mrsilvosa/portfolio/Light-Spectrometre/nucleo-f446re-project/interface.png

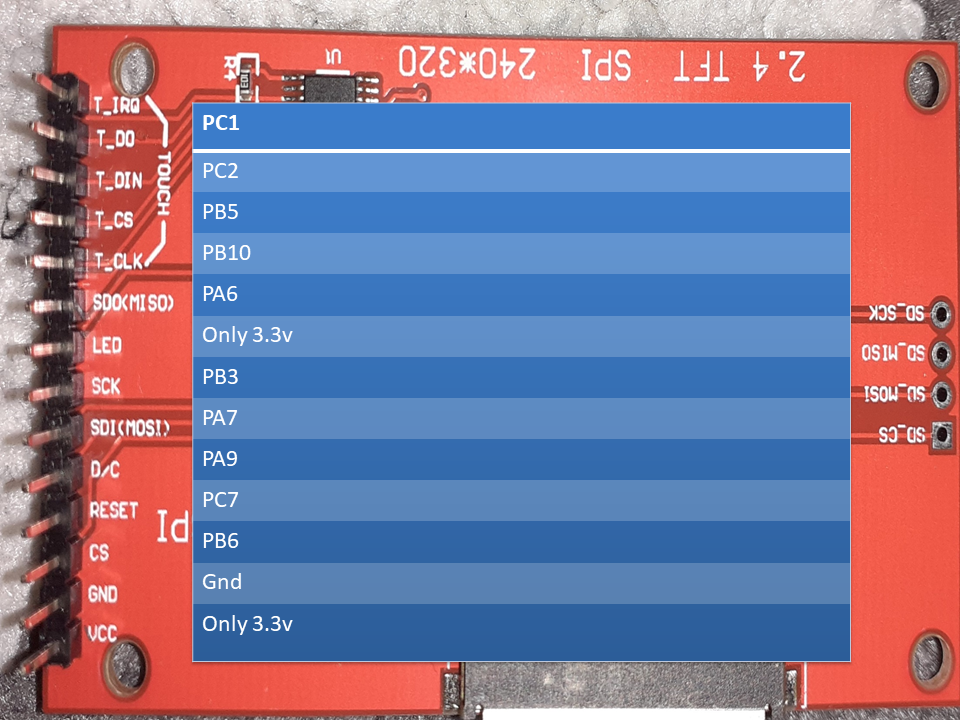
Light-Spectrometre/nucleo-f446re-project/interface.png
