mrsilvosa/portfolio/README.md

# MRS Portfolio
Project's general folder.
You can check for each project within it which will be in separate folders.
