mrsilvosa/portfolio/Light-Spectrometre/README.md

This folder contains every part of the Light Spectrometre project, including PCB layout, manuals detailing most important aspects of the project, microcontroller and PC projects.
