mrsilvosa/portfolio/Light-Spectrometre/Anteproyecto.docx

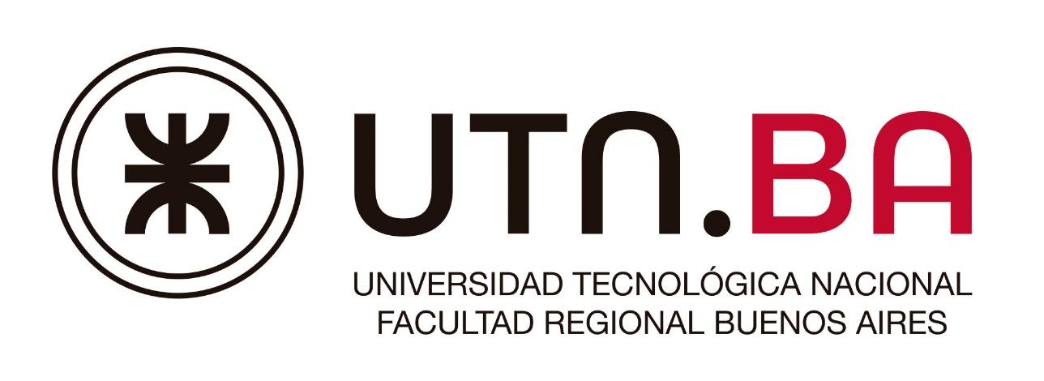
[picture p2: figure]
Qué significa el logo de la UTN.BA? - UTN.BA

Anteproyecto de proyecto integrador de materia

Técnicas Digitales II

Universidad Tecnológica Nacional – Facultad Regional Buenos Aires
Materia: | Técnicas Digitales II
Curso: | R4001
Cuerpo docente: | Ing. Juan Manuel Cruz Ing. Juan Carlos Paradiso Ing. Juan Ignacio Bacigalupo
Título del Proyecto: | Espectrómetro de Luz
Número de grupo: | Grupo -
Integrantes del grupo: | Franco Gabriel Mendez
| Martin Rodriguez Silvosa
Año de cursada: | 2025

# 1. Introducción

Este proyecto tiene como objetivo desarrollar un sistema portátil y de bajo costo capaz de medir el espectro de una fuente de luz visible, utilizando una placa Núcleo F446RE junto con un sensor espectral. A partir de los datos recolectados, se podrá visualizar en tiempo real la distribución espectral, permitiendo comparar diferentes tipos de lámparas, analizar sus pigmentos, etc.

# 2. Desarrollo

- El sensor AS7262 es el que usaremos para medir la intensidad de las longitudes de onda.
- Se utilizan una sensor LDR que nos permite medir un adc la intensidad de luz del ambiente y variar el brillo de la pantalla
- Se utiliza FreeRTOS con sus respectivas tareas para el manejo de toda la información y sensado.
- Utilizaremos la comunicación I2C para la comunicación con el sensor y SPI para la pantalla TFT
- Utilizaremos un Display Gráfico – para el muestreo del espectro de luz.
- Tendrá un USB que nos facilitará el envío de nuestro mediciones a una PC
- Usaremos un gabinete impreso en 3D para mejorar la presentación y para facilitar la interacción con el usuario.

# 3. Diagrama en bloques

Sensores

Micro

Display

PC

Fuente de Luz

# 4. Panel de firmas

| | | Firma
Integrante I | | | Integrante II
Fecha: 3/06/2025 | | | Fecha: 3/06/2025
