mrsilvosa/portfolio/Light-Spectrometre/nucleo-f446re-project/interface.pdf

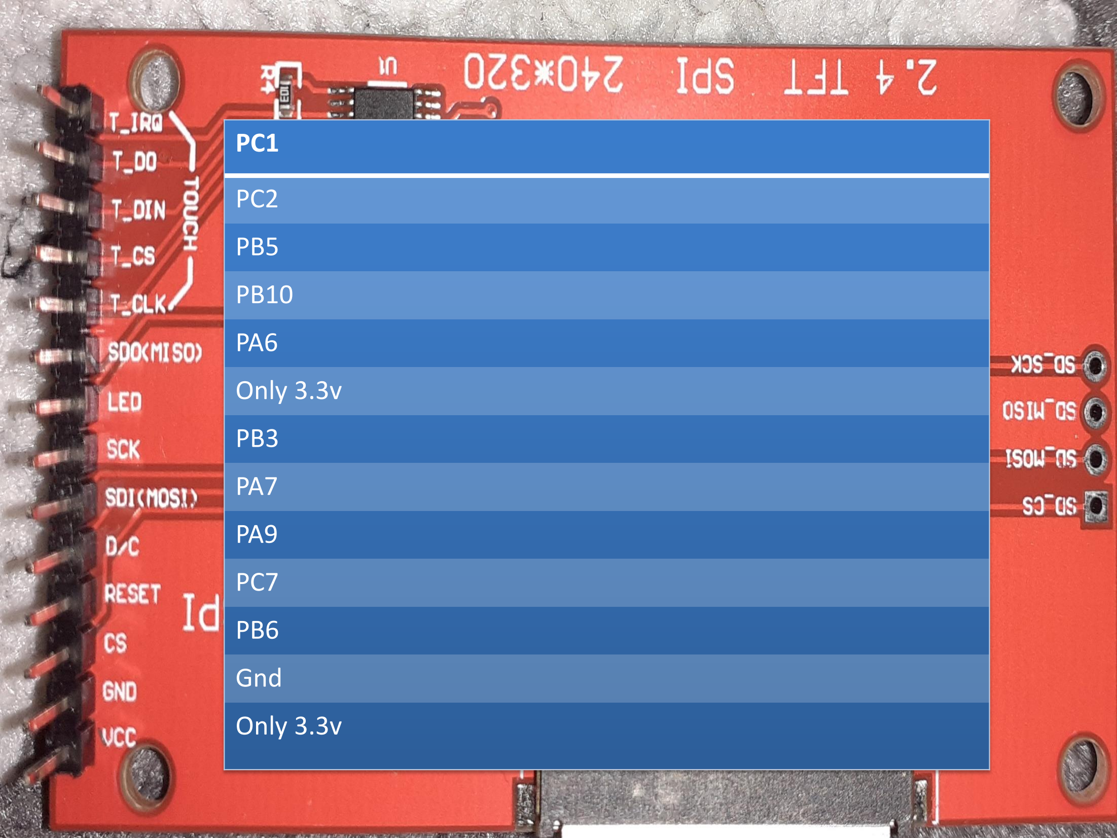
[picture p3: page 1]

PC1

PC2
PB5
PB10
PA6
Only 3.3v
PB3
PA7
PA9
PC7
PB6
Gnd
Only 3.3v
