mrsilvosa/portfolio/Light-Spectrometre/PC-Qt-project/20251220_202518_intensity.ods

index | value
0 | 0,0000480380804
1 | 0,0000623318701
2 | 0,0000805907985
3 | 0,00010382347
4 | 0,000133267808
5 | 0,000170438492
6 | 0,000217174485
7 | 0,000275702099
8 | 0,000348699949
9 | 0,000439376745
10 | 0,000551551755
11 | 0,000689760083
12 | 0,000859338732
13 | 0,0010665491
14 | 0,00131868769
15 | 0,00162421959
16 | 0,00199289736
17 | 0,00243589189
18 | 0,00296595832
19 | 0,00359750492
20 | 0,00434675254
21 | 0,00523182657
22 | 0,00627286127
23 | 0,00749204215
24 | 0,00891361013
25 | 0,0105640134
26 | 0,0124716302
27 | 0,0146668088
28 | 0,0171817038
29 | 0,0200499911
30 | 0,0233065542
31 | 0,026987385
32 | 0,0311287213
33 | 0,0357667431
34 | 0,0409370102
35 | 0,0466736332
36 | 0,0530085415
37 | 0,0599711463
38 | 0,0675866678
39 | 0,0758757815
40 | 0,0848537013
41 | 0,0945290923
42 | 0,104903422
43 | 0,115969732
44 | 0,127713099
45 | 0,140108317
46 | 0,153120711
47 | 0,166705236
48 | 0,180806637
49 | 0,195359349
50 | 0,210287556
51 | 0,22550717
52 | 0,240924224
53 | 0,256437629
54 | 0,271939874
55 | 0,287318051
56 | 0,302457452
57 | 0,317239195
58 | 0,331547469
59 | 0,345267177
60 | 0,358288169
61 | 0,370506585
62 | 0,381826758
63 | 0,39216435
64 | 0,401445061
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
