mrsilvosa/portfolio/Light-Spectrometre/PC-Qt-project/20251221_184616_intensity.ods

index | value
0 | 0,0000802172726
1 | 0,000104334904
2 | 0,000135191978
3 | 0,000174511573
4 | 0,000224409843
5 | 0,000287477509
6 | 0,000366861554
7 | 0,000466373371
8 | 0,000590600539
9 | 0,000745040306
10 | 0,000936237746
11 | 0,0011719662
12 | 0,00146137539
13 | 0,00181520043
14 | 0,00224595354
15 | 0,00276814937
16 | 0,00339851016
17 | 0,00415618997
18 | 0,00506305415
19 | 0,00614379905
20 | 0,00742621813
21 | 0,00894136168
22 | 0,0107237054
23 | 0,0128112147
24 | 0,0152453529
25 | 0,0180713255
26 | 0,021337593
27 | 0,025095934
28 | 0,0294011328
29 | 0,0343104973
30 | 0,0398832634
31 | 0,0461804569
32 | 0,0532633215
33 | 0,0611928403
34 | 0,0700286552
35 | 0,0798277333
36 | 0,0906429216
37 | 0,102522492
38 | 0,115507089
39 | 0,12962921
40 | 0,144911498
41 | 0,161364868
42 | 0,178987399
43 | 0,197762147
44 | 0,217657894
45 | 0,238625228
46 | 0,260597676
47 | 0,283490568
48 | 0,307200909
49 | 0,331607401
50 | 0,356570452
51 | 0,381935567
52 | 0,407530874
53 | 0,43317163
54 | 0,458661377
55 | 0,483794212
56 | 0,508360505
57 | 0,532143235
58 | 0,554930449
59 | 0,576511145
60 | 0,596682787
61 | 0,615253866
62 | 0,632046998
63 | 0,646904349
64 | 0,659686208
65 | 0,670278966
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
