mrsilvosa/portfolio/Light-Spectrometre/PC-Qt-project/20251221_185330_intensity.ods

index | value
0 | 0,000013506261
1 | 0,0000175229688
2 | 0,000022653554
3 | 0,0000291813012
4 | 0,0000374538758
5 | 0,0000478966904
6 | 0,0000610262032
7 | 0,0000774676446
8 | 0,0000979732795
9 | 0,000123444217
10 | 0,000154953028
11 | 0,000193773332
12 | 0,000241403919
13 | 0,000299603096
14 | 0,00037042005
15 | 0,000456231937
16 | 0,000559777603
17 | 0,000684194209
18 | 0,00083306391
19 | 0,00101043296
20 | 0,00122085691
21 | 0,00146942656
22 | 0,0017617963
23 | 0,00210419716
24 | 0,00250343792
25 | 0,00296694739
26 | 0,00350269605
27 | 0,00411921041
28 | 0,00482552219
29 | 0,00563109387
30 | 0,00654572342
31 | 0,00757952873
32 | 0,00874269195
33 | 0,0100453841
34 | 0,0114975991
35 | 0,0131089361
36 | 0,0148883741
37 | 0,0168441944
38 | 0,0189835019
39 | 0,0213121343
40 | 0,0238343887
41 | 0,0265527423
42 | 0,0294676516
43 | 0,0325772092
44 | 0,0358772874
45 | 0,0393608697
46 | 0,0430182926
47 | 0,0468369909
48 | 0,0508015491
49 | 0,0548936613
50 | 0,0590921566
51 | 0,0633735582
52 | 0,067711629
53 | 0,0720781535
54 | 0,0764431208
55 | 0,0807750151
56 | 0,0850418955
57 | 0,0892105848
58 | 0,0932488739
59 | 0,0971247256
60 | 0,100807548
61 | 0,104268558
62 | 0,107481286
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
