mrsilvosa/portfolio/Light-Spectrometre/Manual de Ingenieria.pdf

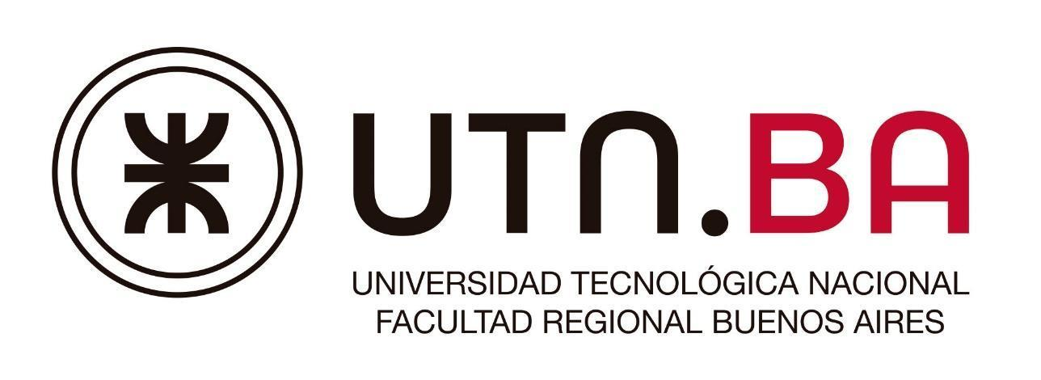
[picture p4: figure]

Manual de Ingeniería Proyecto Integrador Técnicas Digitales II

Universidad Tecnológica Nacional – Facultad Regional Buenos Aires
Materia: | Técnicas Digitales II
Curso: | R4001
Cuerpo docente: | Ing. Juan Manuel Cruz Ing. Juan Carlos Paradiso Ing. Juan Ignacio Bacigalupo
Título del Proyecto: | Espectrómetro de Luz
Número de grupo: | Grupo -
Integrantes del grupo: | Franco Gabriel Méndez
Martín Rodríguez Silvosa
Año de cursada: | 2025

Haga click aquí para volver al índice

# Índice

- Estado del Arte | 3
- Principio de Funcionamiento | 3
- Composición del proyecto | 3
- Esquemáticos y PCB’s | 4
- Código programado, MCU y PC | 10
- Porciones de código relevantes MCU | 11
- Porciones de código relevantes PC | 20
- Consumo Eléctrico: | 23
- Dispositivos y periféricos empleados, detalles | 23
- Tipos de comunicación empleadas | 23
- Cronogramas del proyecto | 24
- Costos del proyecto | 25
- Desafíos | 26
- Conclusiones | 26
- Bibliografía | 27
- Panel de firmas | 27

## - Estado del Arte

El espectrómetro digital está caracterizado por ser una herramienta útil en el análisis de los componentes espectrales de la luz visible, permitiendo medir la intensidad de cada longitud de onda emitida/reflejada por la fuente, calcular indirectamente temperatura de color o iluminancia dependiendo de la aplicación, o evaluar la calidad de la fuente en base a métodos de reproducción de color como los estándares CRI / TM-30.
Convierten estas señales ópticas en datos digitales a partir de métodos de procesamiento de señales a través de algoritmos y software como lo puede ser el análisis de Fourier, para luego en tiempo real obtener información cualitativa y cuantitativa de la luz medida con alta precisión.

## - Principio de Funcionamiento

Nuestro proyecto utiliza principalmente un sensor acondicionado para medir pequeñas bandas de longitud de onda. La luz incide sobre las diferentes subdivisiones de longitud de onda que dispone el dispositivo y se captura una intensidad lumínica sobre cada una mediante un tiempo de integración. Esta información es almacenada en memoria volátil sobre el sensor a la espera de ser leída por el MCU. Una vez capturada y rescatada la información, se procesa mediante un algoritmo estadístico y se refleja el espectro en pantalla con un valor de intensidad por longitud de onda proporcional a la intensidad medida total.

## - Composición del proyecto

Para desarrollar esta tarea, decidimos utilizar los siguientes dispositivos:
- STM32 Núcleo-F446RE como MCU principal
- Pantalla TFT ILI9341 para la visualización de la interfaz gráfica
- Memoria SD integrada dentro del ILI9341 para el almacenamiento del GUI
- Sensor TCS34725 como análisis espectral ante el fallo imprevisto del AS7262
- Sensor LDR de intensidad lumínica para la retroiluminación de la pantalla
- Pulsadores varios para el desplazamiento y selección dentro del GUI
- Baterías AA como fuente de alimentación del dispositivo portátil
- Llave selectora para el encendido y apagado del proyecto
- Conector USB para subir los datos espectrales tomados a PC con aplicación propia
- Gabinete impreso en 3D que almacena todos los dispositivos empleados

## - Esquemáticos y PCB’s

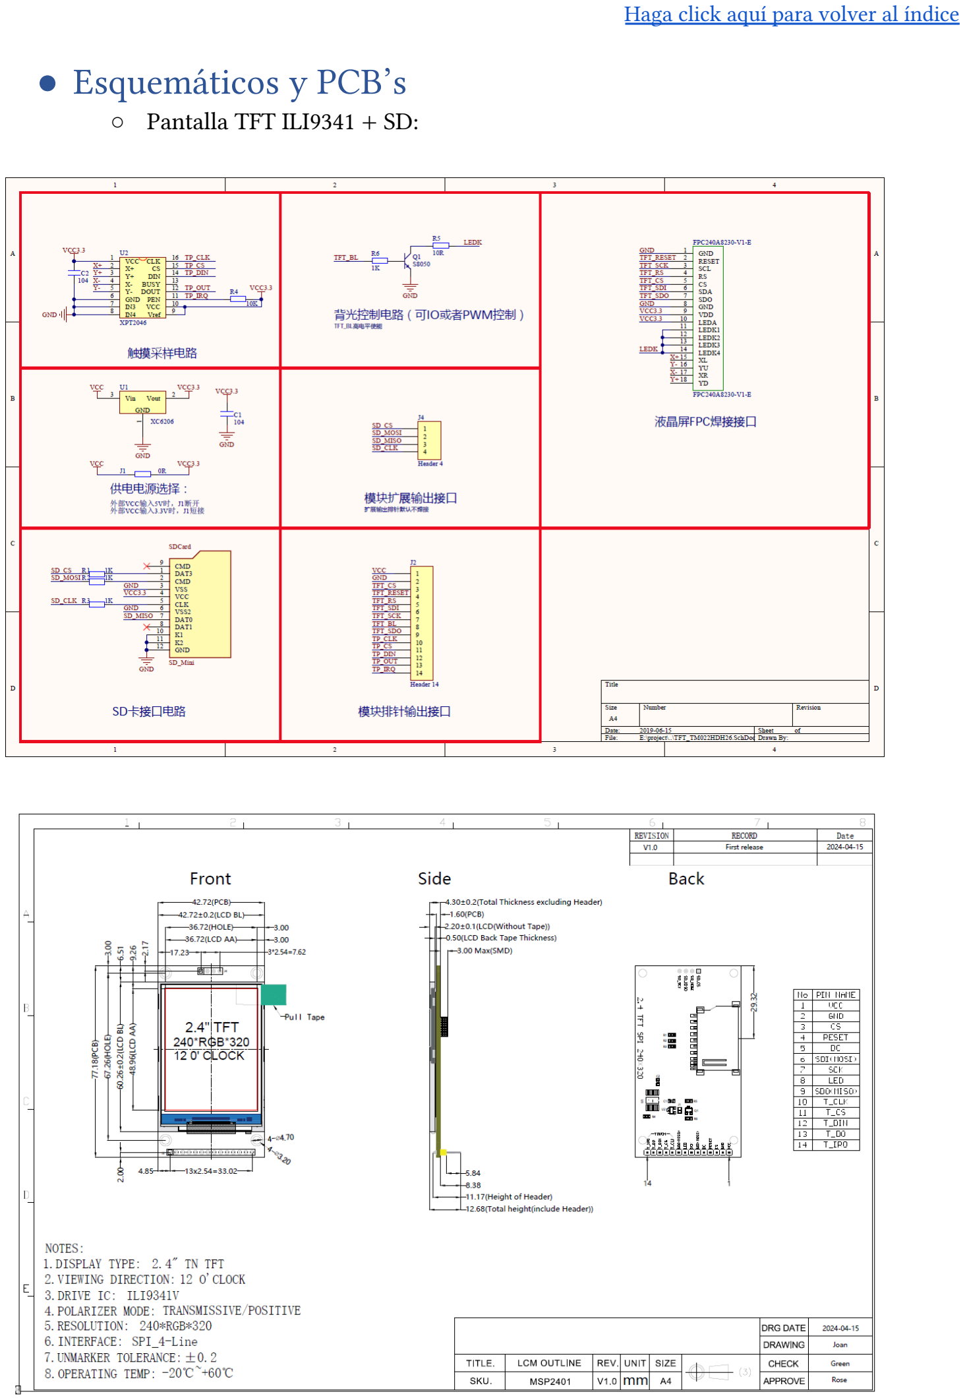
[picture p5: page 4]

- Pantalla TFT ILI9341 + SD:

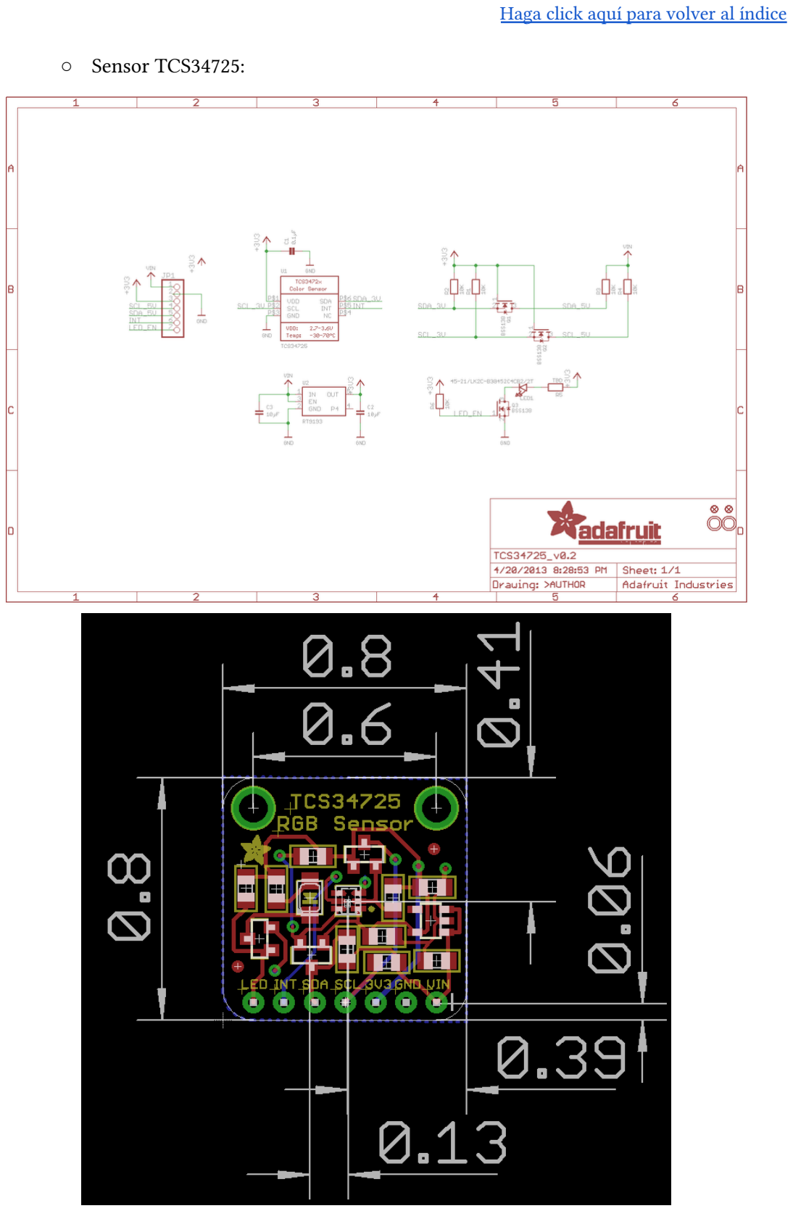
[picture p6: page 5]

Haga click aquí para volver al índice ○ Sensor TCS34725:

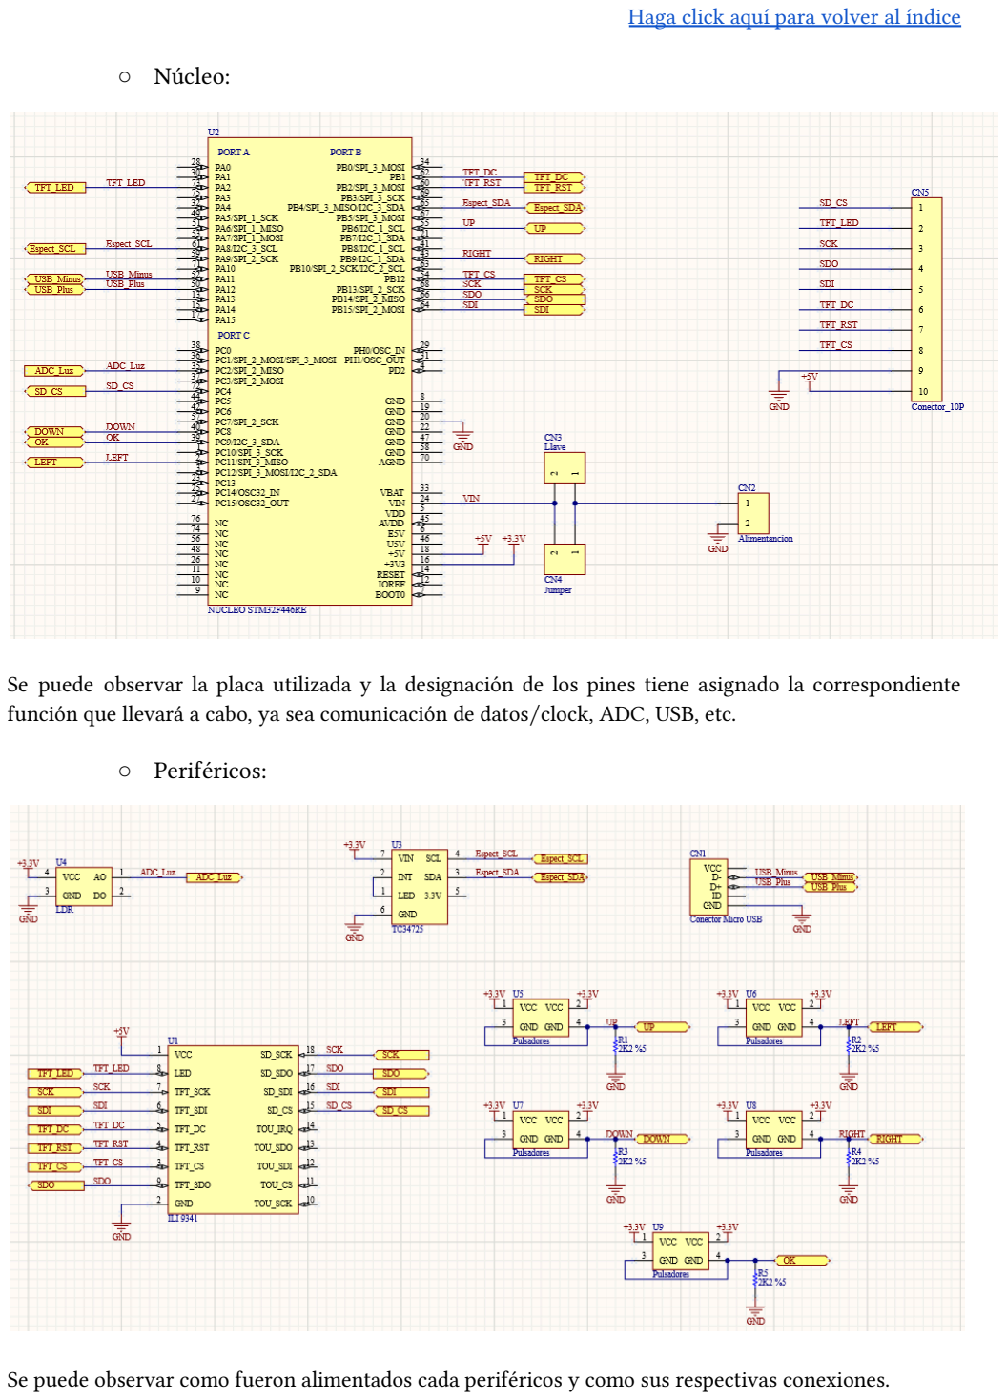
[picture p7: page 6]

- Núcleo:

Se puede observar la placa utilizada y la designación de los pines tiene asignado la correspondiente función que llevará a cabo, ya sea comunicación de datos/clock, ADC, USB, etc.

- Periféricos:

Se puede observar como fueron alimentados cada periféricos y como sus respectivas conexiones.

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
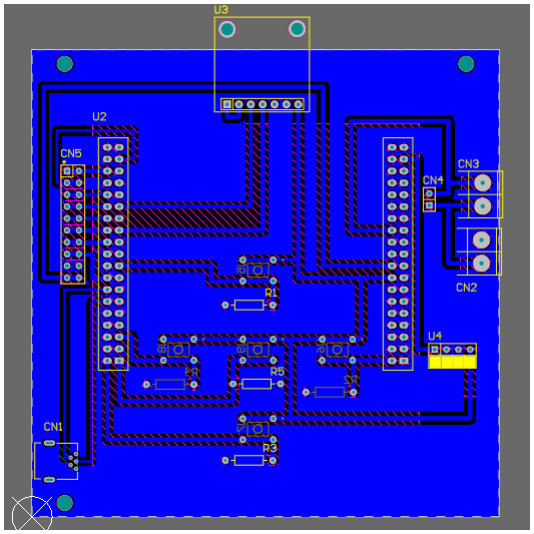
[picture p8: figure]
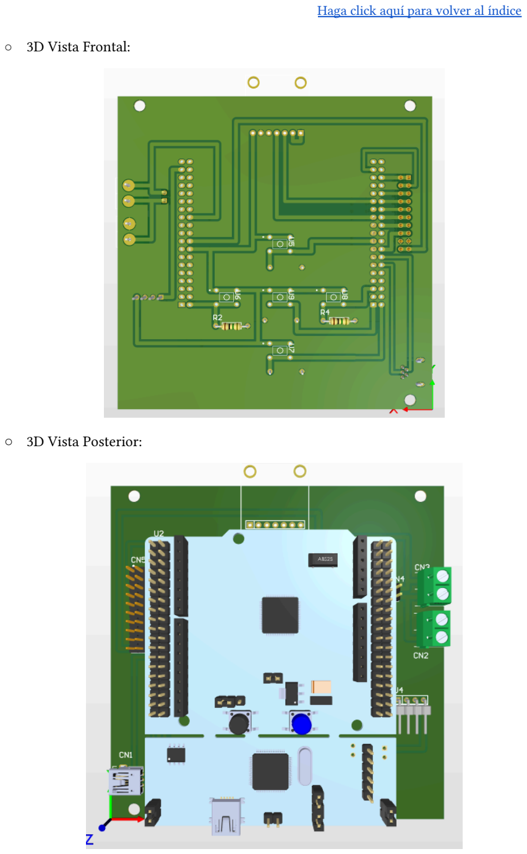
[picture p9: page 8]

- 3D Vista Frontal:
- 3D Vista Posterior:

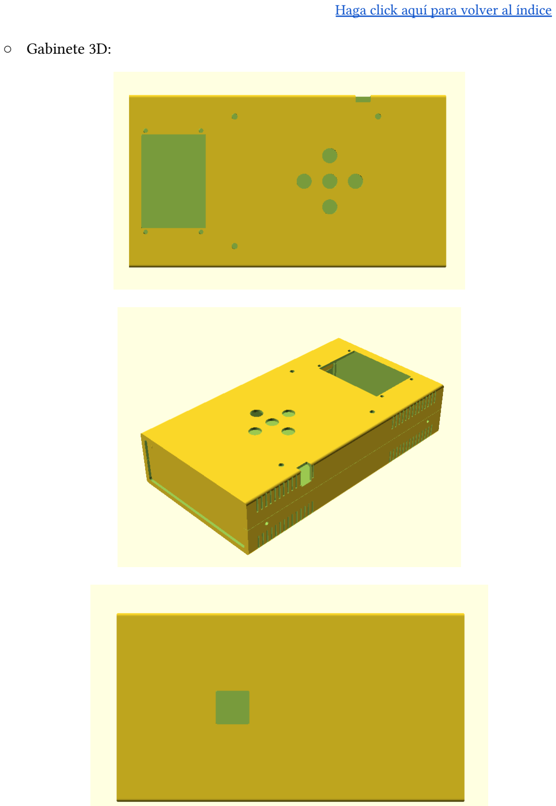
[picture p10: page 9]

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
## - Código programado, MCU y PC

El desarrollo del proyecto contempló la realización de un STM Project dentro del STM32CubeIDE (https://www.st.com/en/development-tools/stm32cubeide.html) + STM32CubeMX (https://www.st.com/en/development-tools/stm32cubemx.html) como software oficial para programar en lenguaje C la Núcleo-F446RE que utilizamos como micro controlador principal. A su vez se realizó una aplicación de PC mediante el uso de Qt Creator (https://doc.qt.io/qtcreator/) programado en C++.
El código del MCU contiene las siguientes librerías utilizadas:
- Librería HAL F4xx (https://www.st.com/resource/en/user_manual/um1725-description-of-stm32f4-hal-and-lowlayer-drivers-stmicroelectronics.pdf) conteniendo todo lo necesario para utilizar los periféricos
- Librería FreeRTOS (https://www.freertos.org/media/2018/FreeRTOS_Reference_Manual_V10.0.0.pdf) conteniendo lo necesario para la implementación de un sistema operativo necesario para mantener el paralelismo de tareas
- Librería USB Device Library (https://www.st.com/resource/en/user_manual/dm00108129.pdf) implementada por STM para facilitar el uso de USB
- Librerías para el manejo del ILI9341 y del TCS34725 provistas por Adafruit (https://www.adafruit.com/?srsltid=AfmBOopEyZhQpWUfbb8MTWzAbxcxK12fJpq_KoYVzk5AQTg48mLEIpyl) y terceros, que fueron modificadas para su uso sobre STM
- Librería SD creada a partir de documentación detallada en clase
El código de PC contiene las siguientes librerías destacadas dentro del entorno Qt:
- Librería QFile (https://doc.qt.io/qt-6/qfile.html) para el manejo de archivos
- Librería QDateTime (https://doc.qt.io/qt-6/qdatetime.html) para la implementación de guardado según fecha de uso
- Librería libusb (https://libusb.info/) para el control y manejo de la comunicación por USB

## - Porciones de código relevantes MCU

Tarea T_LDR(): Tarea de baja prioridad encargada de leer el valor analógico entregado por el módulo LDR. Toma un número de muestras con el ADC que luego se promedia y en base a eso se genera un pulso PWM con un DUTY mínimo y máximo que se inyecta a la pantalla para el manejo de la retroalimentación. A mayor intensidad lumínica ambiente, mayor brillo sobre la pantalla y viceversa.

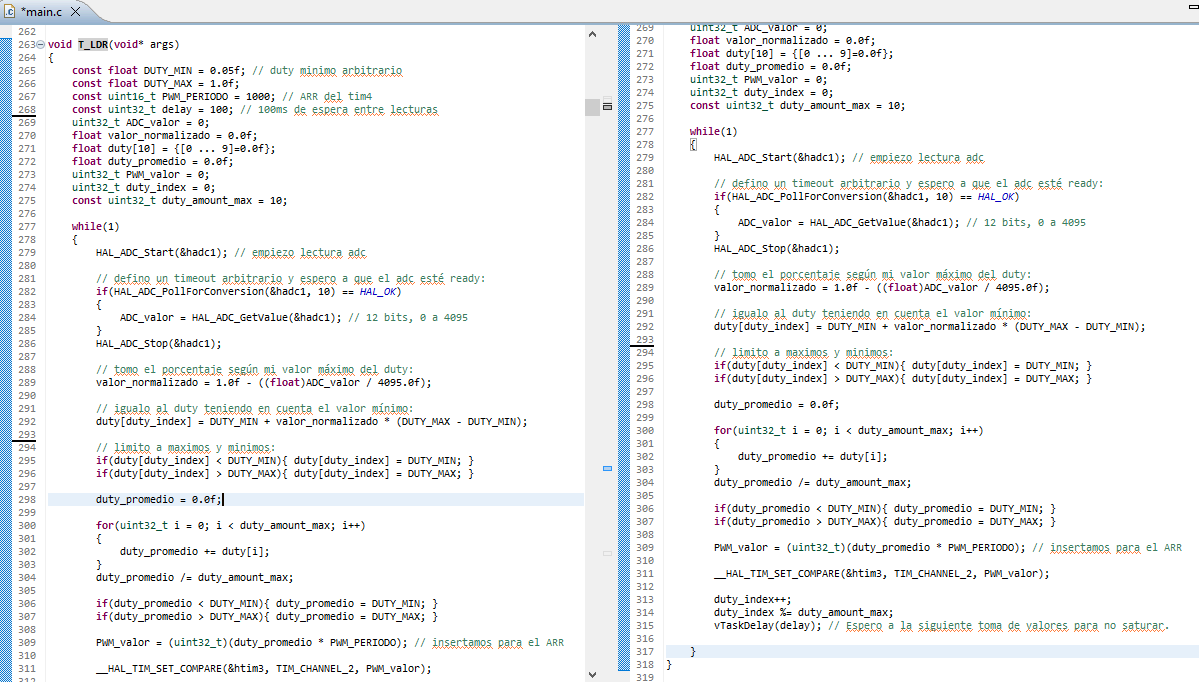
[picture p11: figure]

Tarea T_MdE(): Tarea de alta prioridad encargada del manejo de instancias dentro del menú. Es la tarea principal y por tanto una tarea larga y compleja, encargada de coordinar las acciones que se tienen que realizar para el correcto funcionamiento del dispositivo.

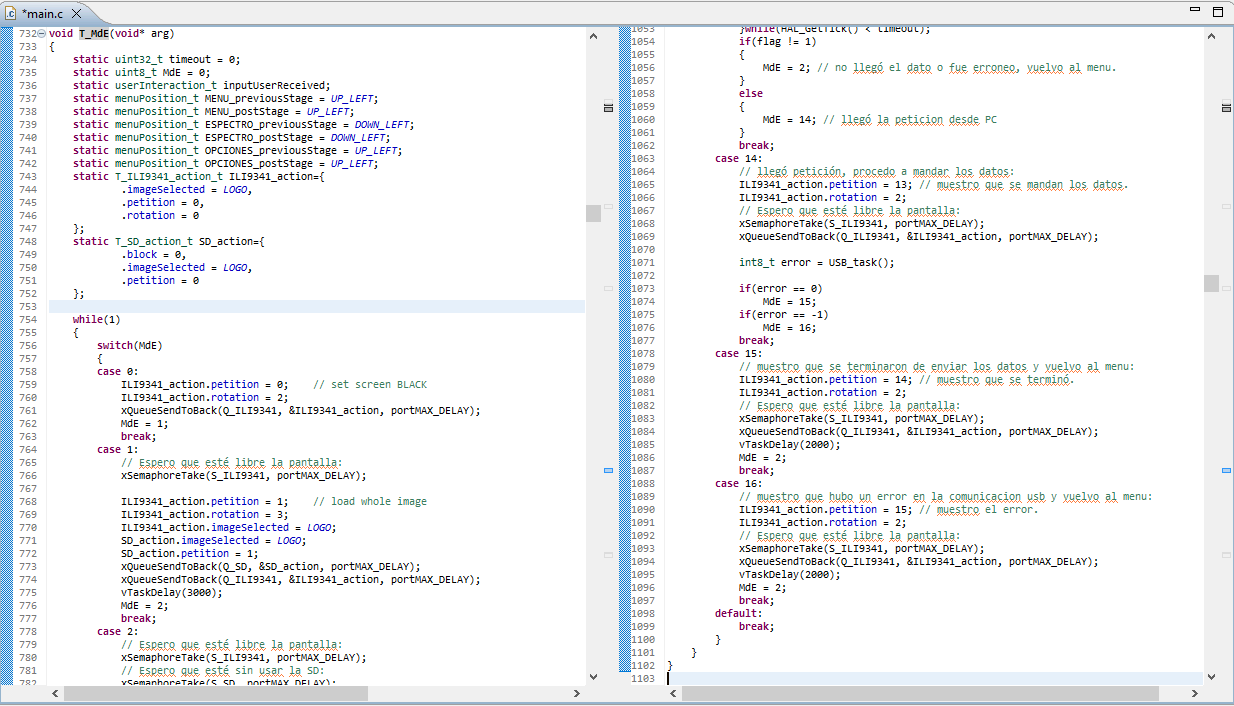
[picture p12: figure]

Tarea T_ILI9341(): Tarea de alta prioridad encargada del manejo exclusivo de la pantalla. Dependiendo de las peticiones que le lleguen, determina lo que tiene que mostrar en pantalla. Su tiempo de ejecución se confina a únicamente cuando le llega 1 petición.

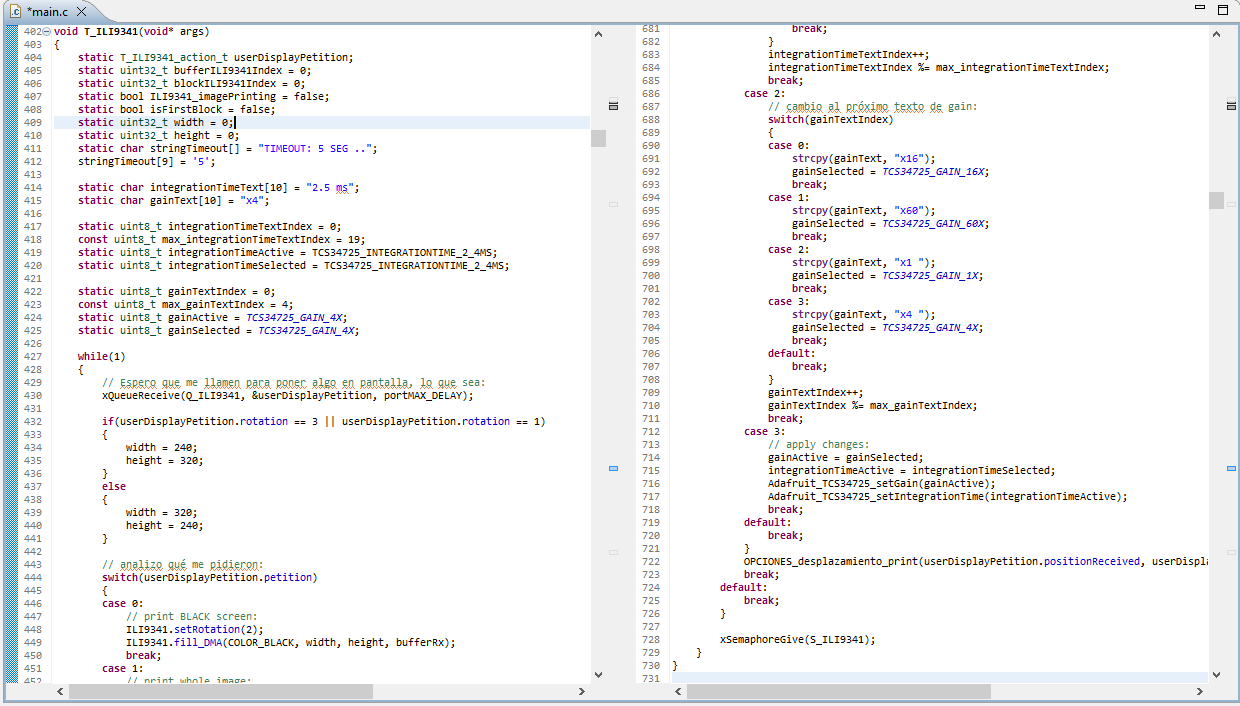
[picture p13: figure]

Tarea T_SD(): Tarea de alta prioridad encargada del manejo exclusivo de la SD. Dependiendo de las peticiones que le lleguen, determina la información que tiene que rescatar de memoria. Su tiempo de ejecución se confina a únicamente cuando le llega 1 petición.

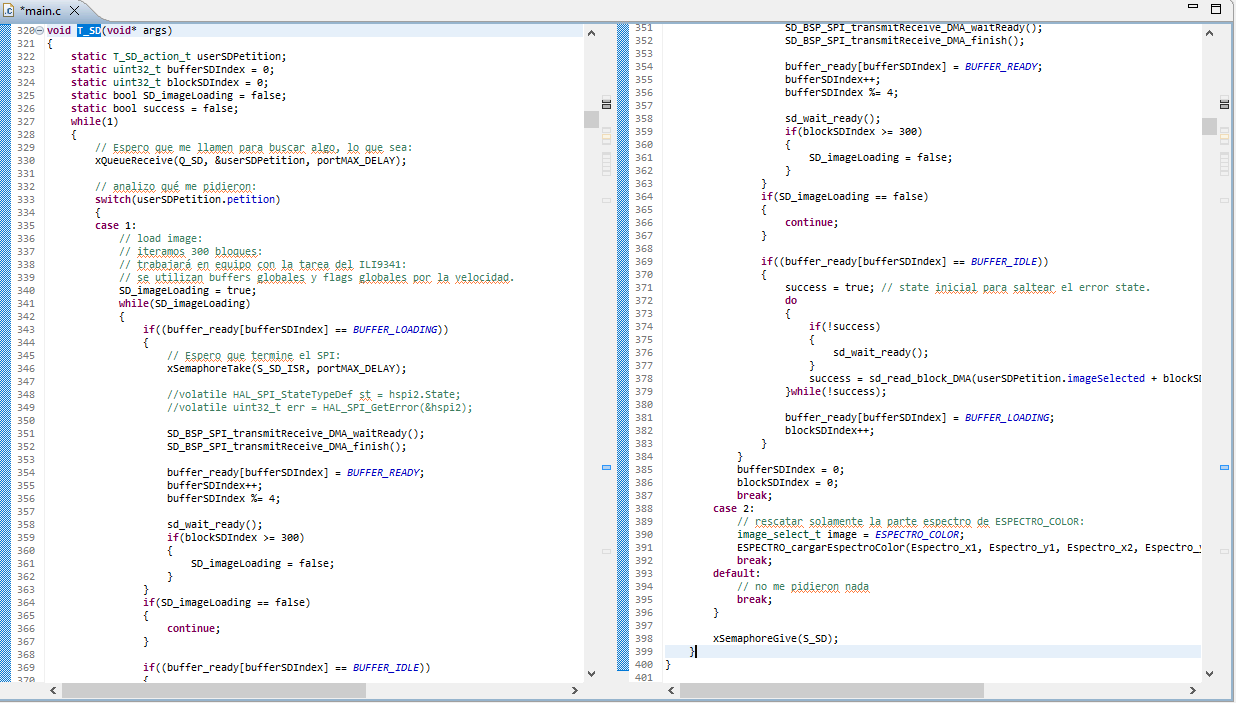
[picture p14: figure]

Tareas T_SD + T_ILI9341, funcionamiento en conjunto: A continuación se detallarán las
porciones de código que se ejecutan en la instancia de recuperación de la imagen en memoria SD y su impresión sobre la pantalla. Para llevar a cabo esta función, se tuvo que implementar un sistema de alternancia de buffers cuya escritura se hace a través de canales DMA, lo cual conllevó un desafío tecnológico para su correcta sincronización y permitió ejecutar la impresión de las diapositivas del menú principal a velocidades inalcanzables de otra manera, logrando un tiempo de impresión de la imagen total menor a 300 milisegundos.

Tarea T_SD, rescate de información: Después de recibir la directiva de rescatar determinada imagen de memoria de parte de la tarea principal, se predispone a iterar el respectivo rescate hasta haber cargado la totalidad de la imagen. La información en la SD está guardada y se accede por bloques de memoria de 512 bytes, y cada imagen ocupa un total de 300 bloques exactos en memoria. Se dispone de 4 buffers cada uno con su respectivo indicador de estado actual. Los buffers empiezan en un estado inactivo, lo cual le da la indicación a la tarea SD que puede sobreescribirlos con nueva información.
Lo primero que realiza la tarea es rescatar 1 bloque de memoria utilizando 1 canal DMA. Para ello ejecuta 1 función encargada de pedir la información, pero el canal DMA será el encargado de indicar que la información ya fue cargada sobre el buffer, dejando en el mientras tanto al buffer en estado LOADING para indicarle a la tarea su estado actual y que tiene que esperar. Una vez que el canal DMA libera al buffer, se indica que el estado actual de ese buffer es READY y se deja listo para su impresión en pantalla. Hecho esto, se predispone a realizar la carga del próximo bloque con el próximo buffer que esté en estado inactivo. A medida que la pantalla imprima la información rescatada, irá liberando los buffers antiguos para poder reutilizarlos.

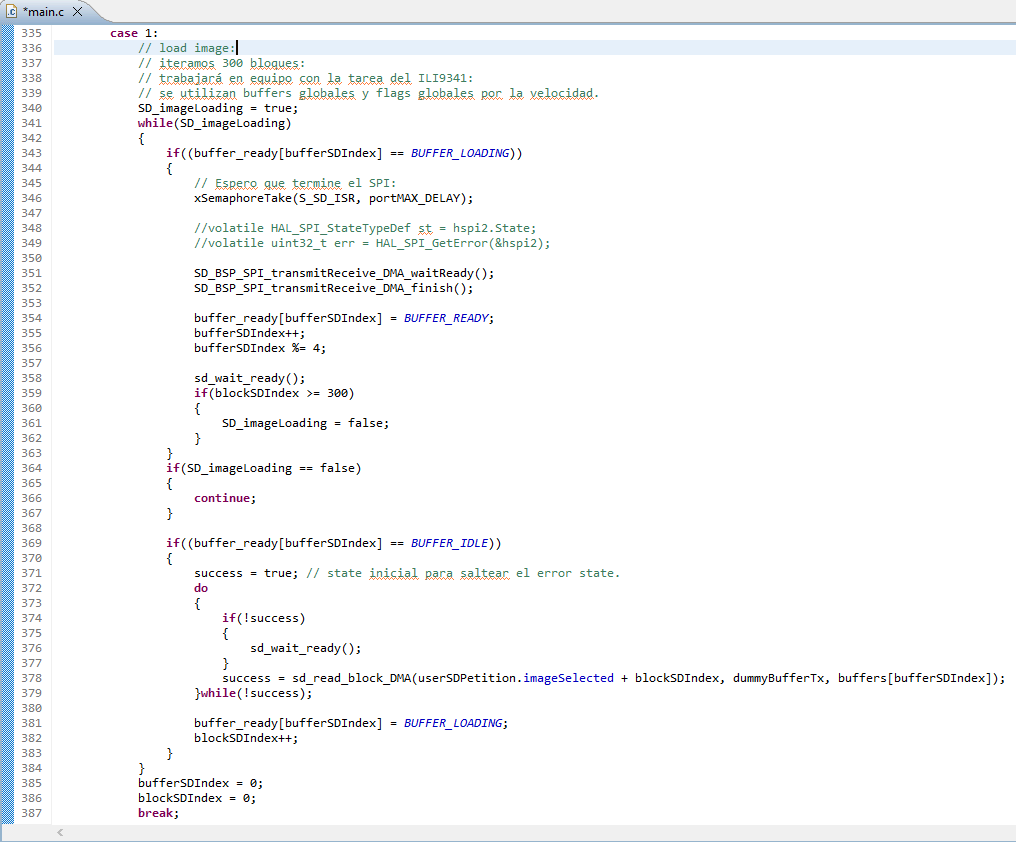
[picture p15: figure]

Tarea T_ILI9341, impresión de información: Después de recibir la directiva de imprimir determinada imagen en pantalla de parte de la tarea principal, se predispone a iterar la respectiva impresión hasta haber impreso la totalidad de la imagen.
Lo primero que realiza la tarea es buscar que el primer buffer esté en estado READY. Una vez que esto suceda, procede a ejecutar una función encargada de imprimir el buffer en pantalla mediante el uso de 1 canal DMA, pero el canal DMA será el encargado de indicar que la información ya fue impresa en la pantalla, dejando en el mientras tanto al buffer en estado PRINTING para indicarle a la tarea su estado actual y que tiene que esperar. Una vez que el canal DMA libera al buffer, se indica que el estado actual de ese buffer es IDLE y se deja listo para un nuevo rescate en memoria. Hecho esto, se predispone a realizar la carga del próximo buffer que esté en estado READY sobre la pantalla. A medida que la SD rescate nueva información, irá reescribiendo los buffers antiguos para poder seguir imprimiendo.

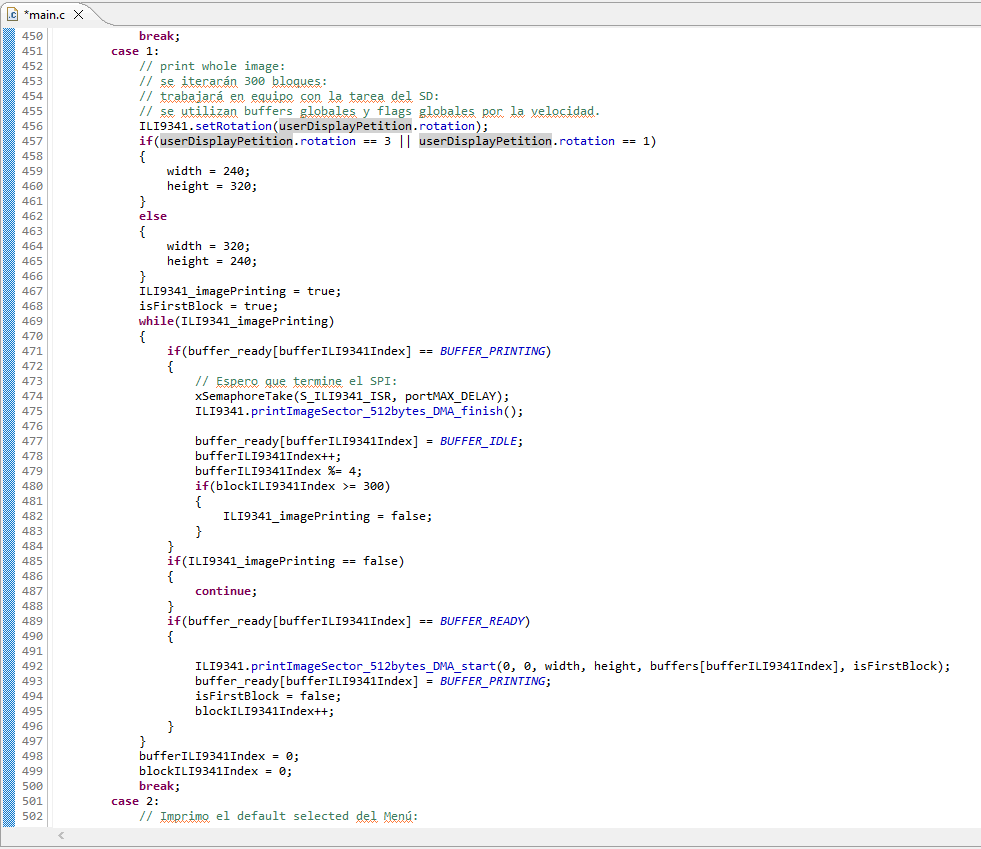
[picture p16: figure]

Liberación de los buffers, canales DMA, interrupciones del sistema: Como mencionamos antes,
los canales DMA liberan los buffers de ambas tareas previas para indicar la terminación de la operación. Existen 3 canales DMA que estarán linkeados a diferentes callbacks, ya que la SD utiliza un callback de escritura y lectura mientras que la pantalla utiliza un callback de sólo escritura.

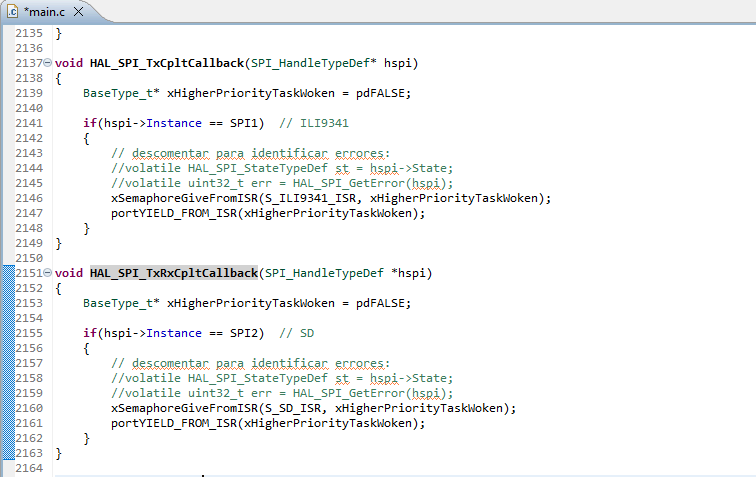
[picture p17: figure]

Tarea T_SD, rescate del espectro total: Una de las directivas que acepta la tarea SD es la de rescatar y colocar en un buffer la totalidad de los píxeles correspondientes al espectro entero con la máxima intensidad posible. Esto se realiza para que luego la pantalla pueda elegir qué píxeles utilizar dependiendo de lo que haya dado la medición espectral. El espectro está guardado como una diapositiva entera para no alterar el algoritmo de guardado de imágenes de la SD, por lo que tendremos que generar una lógica de rescate que me permita obtener exclusivamente aquellos píxeles relevantes y minimizar memoria utilizada, ya que estas imágenes ocupan mucho espacio.

Función ESPECTRO_cargarEspectroColor(): Aquí se confina la lógica necesaria para rescatar los píxeles relevantes para la impresión del espectro. Se realizan múltiples lecturas sobre múltiples bloques de la diapositiva en SD en busca de los píxeles pertinentes

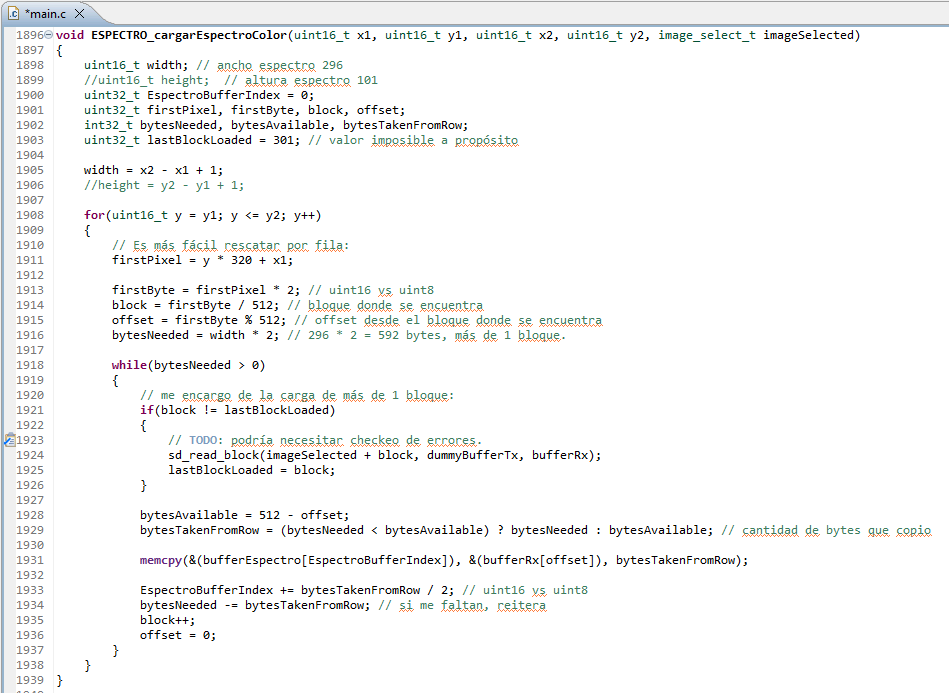
[picture p18: figure]

Tarea T_ILI9341, impresión del espectro total: Una de las directivas que acepta la tarea ILI9341 es la de procesar la información recibida desde el sensor espectral e imprimir sobre la diapositiva espectral el espectro resultante de la medición. Se tendrá que determinar el nivel de intensidad que hay sobre cada longitud de onda con una resolución de 1 nanómetro y luego se imprimirá verticalmente la intensidad relativa que irá de 0.0 a 1.0. Para la impresión se utilizará el buffer previamente cargado por la SD con el espectro color.

Función ESPECTRO_algoritmoIntensidadEspectro(): Aquí se confina la lógica necesaria para el análisis del espectro y su impresión en pantalla. Se realiza la toma de mediciones desde el sensor espectral, se verifica que se encuentre en rangos coherentes y se normaliza en base a la intensidad total medida. Luego se genera un vector flotante que abarca la totalidad del espectro visible y define un nivel de intensidad para cada longitud de onda con una resolución de 1 nanómetro en base a un análisis estadístico de la información recopilada. Una vez obtenido esto, se procede a mostrar en pantalla aquellos píxeles de intensidad correspondientes a la intensidad relativa medida en cada longitud de onda.

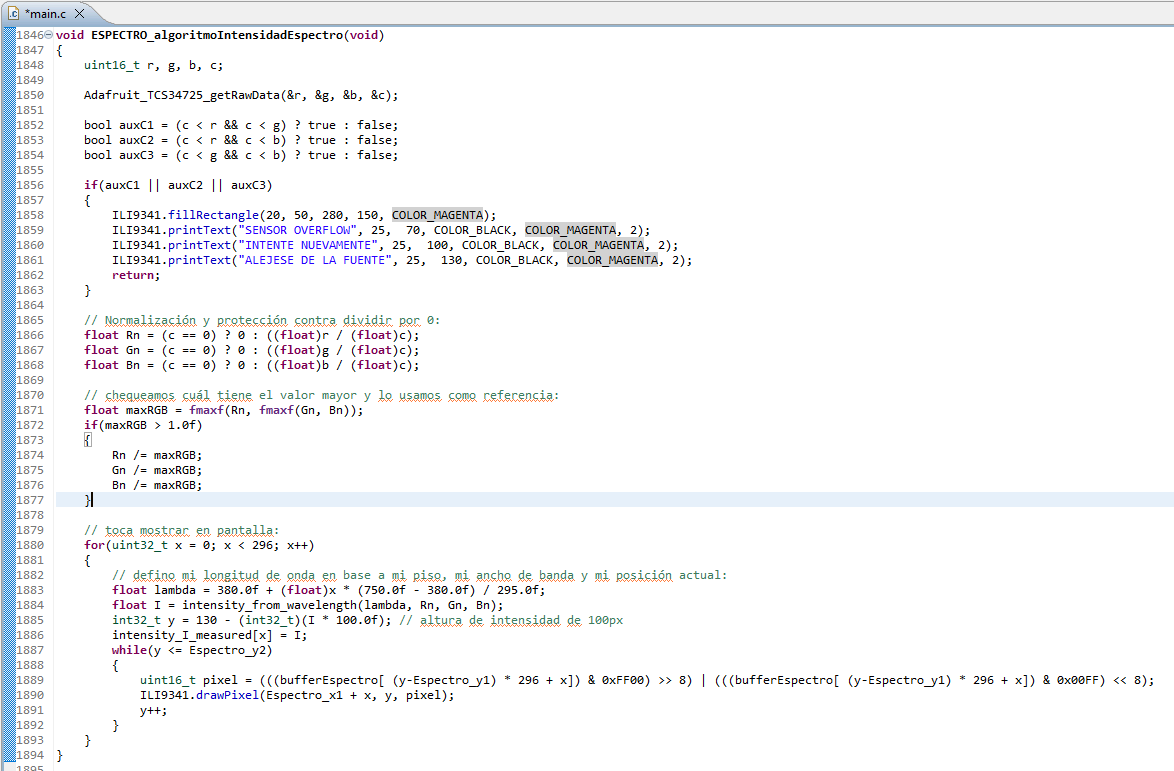
[picture p19: figure]

Subtarea usb_task(): Subrutina que ejecuta la tarea principal al alcanzar cierta instancia. Su tiempo de vida está limitado a cuando el usuario intenta enviar el espectro guardado a la PC. Su objetivo es identificar si llegó una petición de lectura desde PC mediante el periférico USB y de suceder eso, enviar por USB los datos guardados del espectro cuando la tarea principal se lo pida. La información total a enviar es de 296 flotantes provista por el sistema en una etapa previa, por lo que utilizando transferencias de 64 bytes se tiene que iterar el comando de envío hasta que se haya enviado la totalidad de la información.

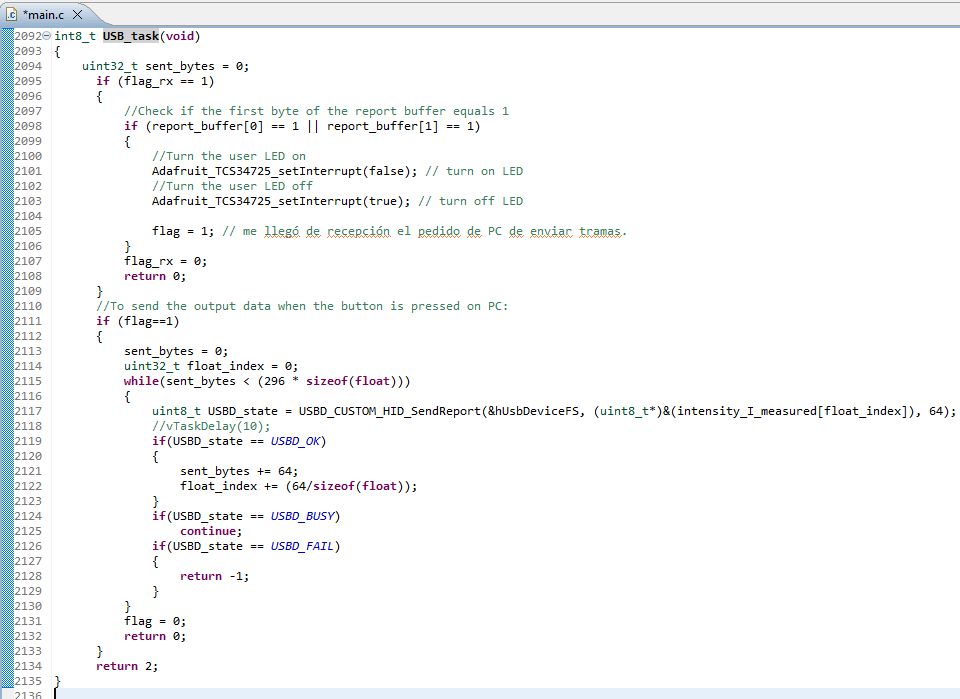
[picture p20: figure]

Tarea T_detectar_pulsador(): Tarea de baja prioridad encargada de leer las entradas de los diferentes pulsadores que se utilizan para manejarse por el menú. Su uso es habilitado exclusivamente en ciertas instancias del menú. Su tarea es la de identificar si alguno de los pulsadores fue presionado y de haberlo sido, determinar si siguen pulsados después de un período corto de tiempo, momento en donde se envía a la tarea principal el botón que fue presionado. Luego se espera a que la tarea principal informe que la acción pulsada ya fue realizada y que la tarea pulsadores ya puede seguir leyendo las entradas nuevamente, no sin antes ratificar que el botón presionado previamente fue soltado.

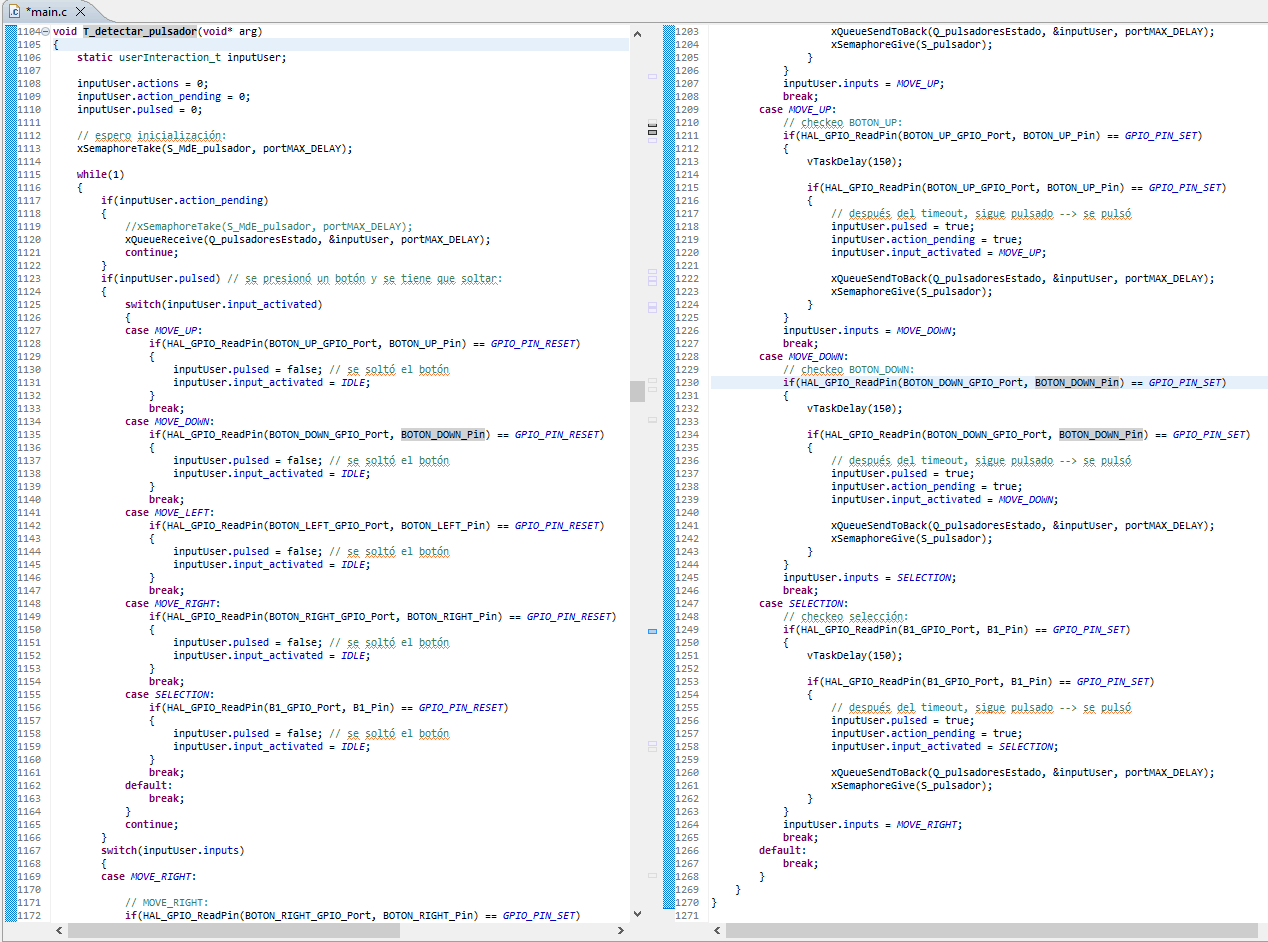
[picture p21: figure]

## - Porciones de código relevantes PC

Interfaz gráfica UI: La siguiente es una imagen de la aplicación en funcionamiento. Se dispone de 3 botones principales, uno para conectar la PC con el MCU, otro para pedir la información y guardarla en un archivo, y por último un botón de desconexión al terminar de utilizarla.

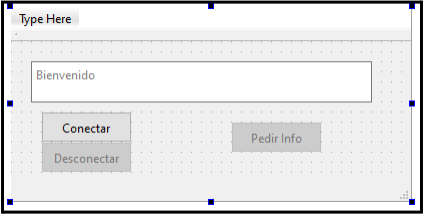
[picture p22: figure]

Botón Conectar: Al clickear el botón conectar se ejecuta el evento de botón clickeado, el cual se encarga de buscar entre todos los dispositivos USB conectados aquel que tenga el VID y PID específico de nuestro dispositivo, dispuesto arbitrariamente durante el desarrollo del proyecto. Una vez encontrado, se dispone a abrir una conexión con él y actualiza la interfaz gráfica.

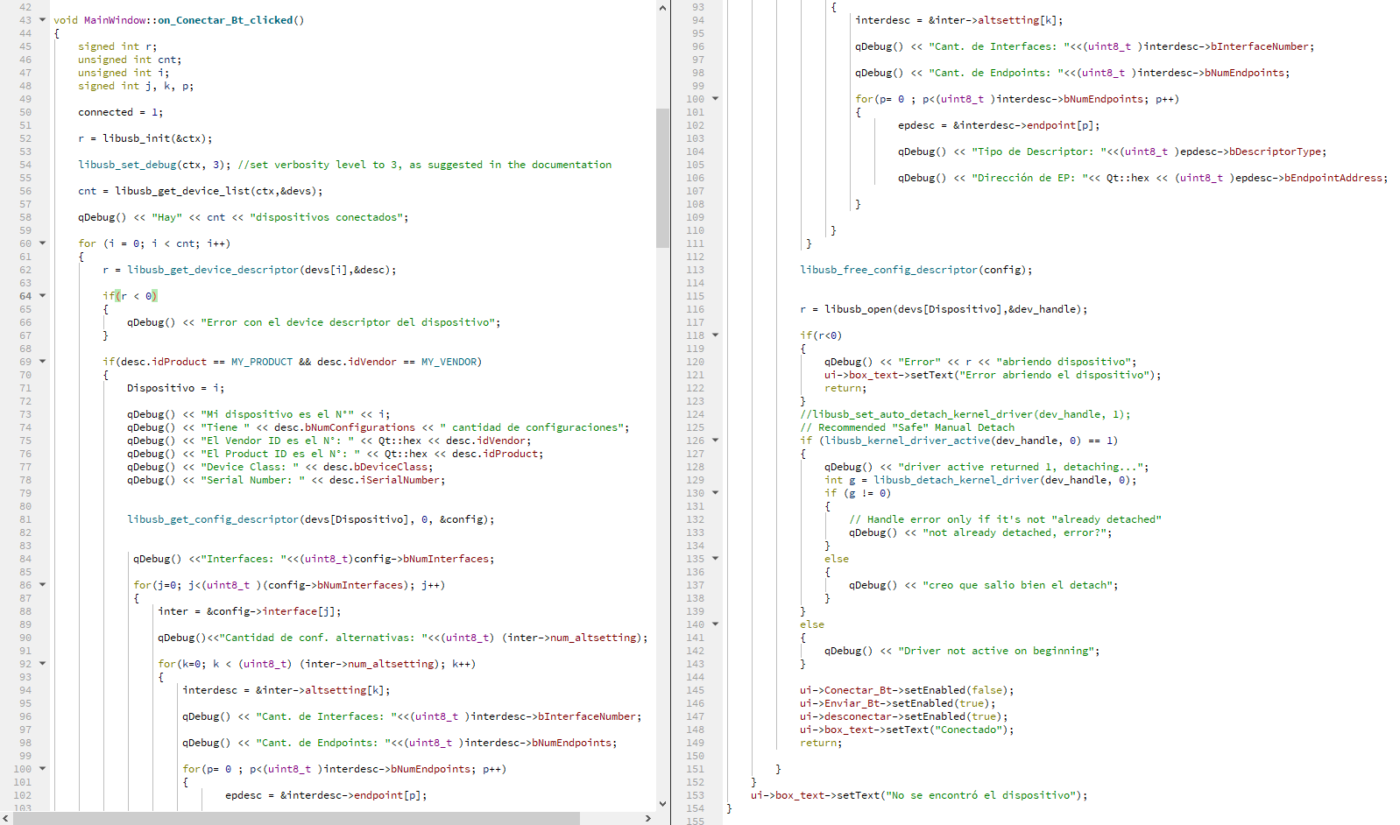
[picture p23: figure]

Botón Pedir Info: Al clickear el botón Pedir Info se ejecuta el evento de botón clickeado, el cual inicia la búsqueda de información desde el MCU y de ser exitosa, guarda el contenido en un archivo .csv con el nombre de la fecha y hora actuales preguntándole al usuario dónde quiere guardarlo. Este botón debe ser clickeado luego de seleccionar en el dispositivo la opción de subir datos a PC por USB e inicie el timeout.

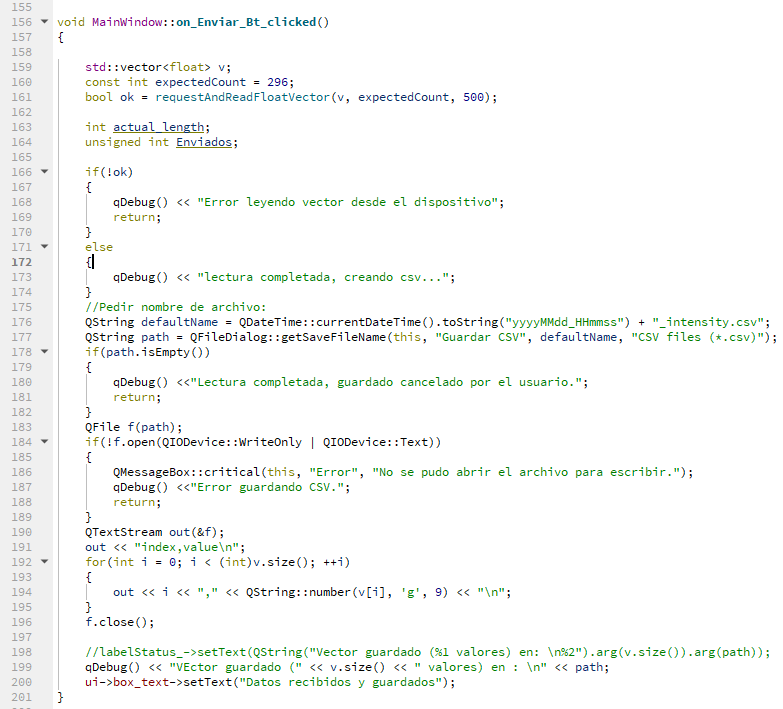
[picture p24: figure]

Función requestAndReadFloatVector(): Esta función ejecutada al clickear Pedir Info se encarga de notificar al MCU que quiero recibir la información guardada del espectro y procede a recibir múltiples paquetes hasta haber guardado el espectro completo. Luego, antes de devolver la información recibida, trabaja los datos para volver a recomponer los valores flotantes en base a los bytes recibidos.

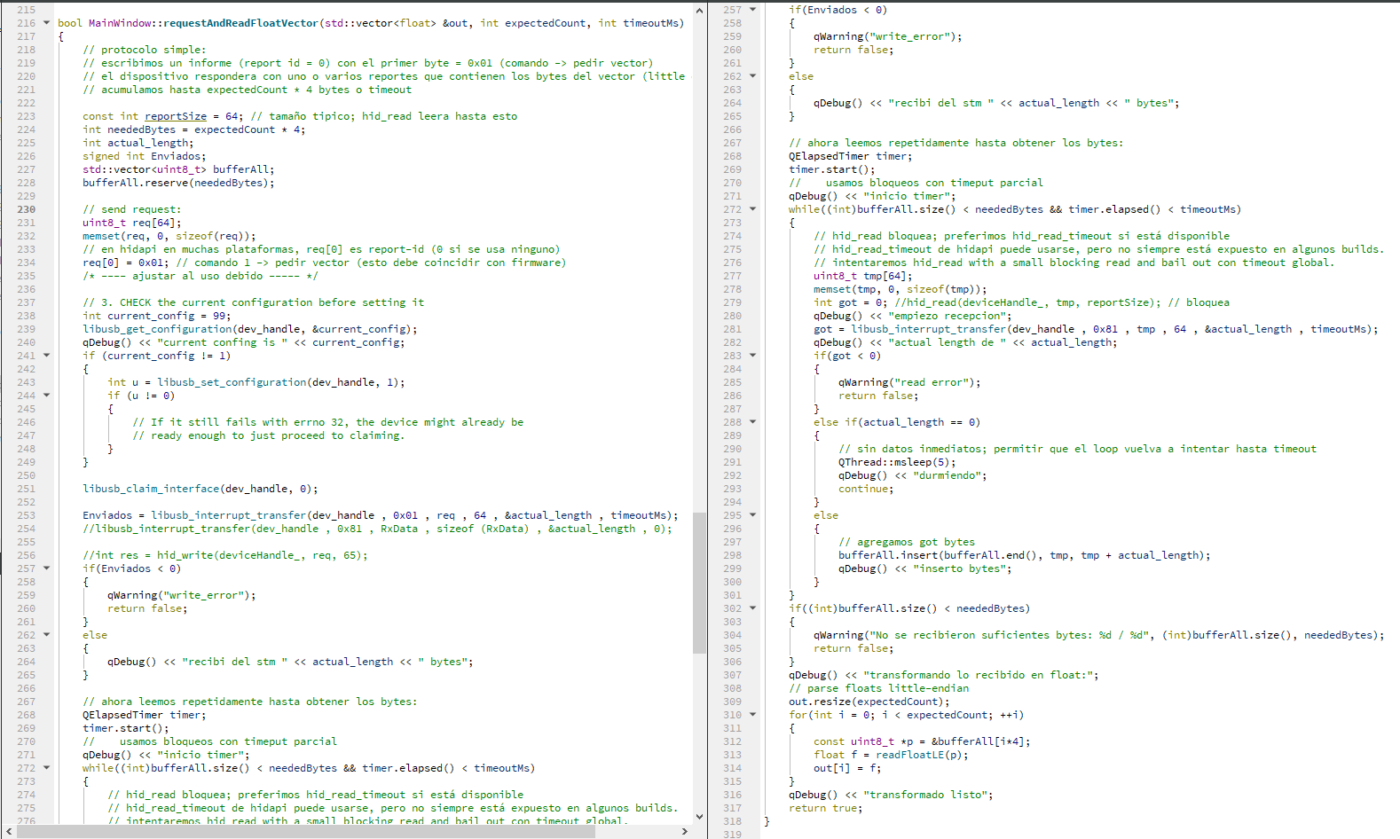
[picture p25: figure]

Botón Desconectar: Al clickear el botón Desconectar se ejecuta el evento de botón clickeado, el cual simplemente cierra la conexión por USB con el MCU para evitar dejar sockets abiertos.

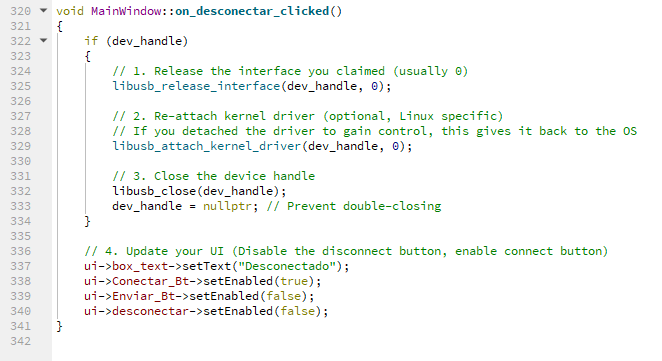
[picture p26: figure]

## - Consumo Eléctrico:

Al ser un proyecto alimentado por pilas (portátil) y no por una fuente regulada (enchufable a la red eléctrica), se midió el consumo de corriente y nos dio un valor de 150-200 [mA].
Usando 4 pilas de 1.5V de 2000 mAh nos da una autonomía aproximada de 10 horas, pero hay que tener en cuenta que el voltaje suministrado debe ser mayor a 5.30 [V].
6V x t = 5.3V
t = 0.88.
Las pilas deben usarse en entre un 10% y 12%, con un consumo de 200 mA podemos asegurar una autonomía de 1 Hora 15 minutos aproximadamente teniendo en cuenta que las pilas pueden suministrar más de 6V en el peor de los casos.

## - Dispositivos y periféricos empleados, detalles

- Pantalla TFT 2.4” ILI9341
- Memoria SD de 16GB
- Sensor LDR
- Sensor RGB TCS34725
- Tact Switch’s 6mm x 6mm
- Mini USB tipo B
- Placa PCB diseñada para el mismo

## - Tipos de comunicación empleadas

Se usaron 3 tipos de comunicaciones:
SPI la cual se empleó para la comunicación de la pantalla TFT y la SD.
I2C para la comunicación del módulo TCS34725
USB para la comunicación con la PC para transmitir la información obtenida y almacenarla en un archivo.

## - Cronogramas del proyecto

Actividad | Responsable | Fecha de Inicio | Fecha Final | Estado
Realización de Idea Fuerza | Todos | 11-05-2025 | 12-05-2025 | Completada
Entrega de Idea Fuerza | Todos | 14-05-2025 | 14-05-2025 | Completada
Realización de Anteproyecto | Todos | 10-06-2025 | 12-06-2025 | Completada
Entrega de Anteproyecto | Todos | 14-06-2025 | 14-06-2025 | Completada
Primera compra de componentes | Franco Mendez | 15-08-2025 | 15-08-2025 | Completada
Programación de Pantalla TFT | Martin Silvosa | 16-10-2025 | 25-10-2025 | Completada
Diseño de la Placa | Franco Mendez | 17-10-2025 | 24-10-2025 | Completada
Programación de ADC | Martin Silvosa | 26-10-2025 | 28-10-2025 | Completada
Programacion sensor RGB | Martin Silvosa | 1-11-2025 | 6-11-2025 | Completada
Segunda compra de componentes | Franco Mendez | 10-11-2025 | 11-11-2025 | Completada
Fabricación de la Placa | Franco Mendez | 12-11-2025 | 13-11-2025 | Completada
Diseño de Maqueta 3D | Franco Mendez | 14-11-2025 | 16-11-2025 | Completada
Fabricación de Maqueta 3D | Franco Mendez | 17-11-2025 | 17-11-2025 | Completada
Programación QT | Martin Silvosa | 20-11-2025 | 23-11-2025 | Completada
Ensamble y testeo de Placa | Todos | 1-12-2025 | 1-12-2025 | Completada
Arreglo de Problemas | Todos | 2-12-2025 | 14-12-2025 | Completada
Segundo Testeo del Proyecto | Todos | 16-12-2025 | 16-12-2025 | Completada
Arreglo de Problemas | Todos | 16-12-2025 | 22-12-2025 | Completada
Entrega Final | Todos | 23-12-2025 | 23-12-2025 | Completada

## - Costos del proyecto

Productos | Precio [ARG]
Pantalla TFT 2.4” | $18.600
Sensor LDR | $2.053
Sensor RGB TCS34725 | $13.341
Portapilas | $1.611
Pilas | $6.500
Impresión 3D | $6000
NúcleoF446RE | $24.690
Placa de cobre | $1.969
USB | $1.733
Borneras, botones y elementos Pasivos | $1200
Subtotal: | $77.697

Teniendo en cuenta la participación de dos Profesionales Juniors y un estimado de 50 Hs se trabajo y según la Copitec. (https://www.copitec.org.ar/honorario-profesional-indicativo/)

Subtotal | $77.697
Mano de obra | $9.250.000
Total | $9.327.697

Haciendo la sumatoria de todos los costos termina dando un valor todo el proyecto

## - Desafíos

Diseño:
A la hora de plantear la interfaz gráfica que se le mostraría al usuario, habíamos empezado con una resolución menor a la actual, pero rápidamente nos dimos cuenta que no sería suficiente para mostrar la información necesaria que queríamos visualizar, por lo que triplicamos la resolución superficial y eso conllevó a que las diapositivas necesarias para el menú gráfico fueran muy pesadas en términos de memoria FLASH y ya no cabrían sobre la núcleo, necesitando así una memoria externa y optando por utilizar la ranura SD ya integrada por el TFT ILI9341.
Ensamblaje:
Una de las problemáticas encontradas fue que la placa fue diseñada para usar tanto la memoria SD como la pantalla por el mismo puerto SPI, pero todo el código estaba diseñado para que funcione en distintos SPI, por lo que se optó por usar cables dupont y conectarlos directamente a la Núcleo en vez de rediseñar la placa.
Otra problemática fue que al alimentar la núcleo de forma externa, éste no iniciaba por sí solo tras energizar la placa, necesitando apretar el botón de RESET para que inicie normalmente. Se optó por colocar un RC de 330k/100uF entre los pines NRST y GND. Esto logró que se realizara un reinicio automático 4 segundos después del energizado del dispositivo y que el proyecto funcione con normalidad. Se trató de elegir diferentes valores de capacitores pero no se obtuvo un reinicio más rápido, sin embargo valores más grandes lograban un reinicio más lento.

## - Conclusiones

Fuimos capaces de integrar tanto los conocimientos teóricos como los prácticos en el transcurso de todo el proyecto como puede ser el uso del microcontrolador y programación en sistemas embebidos en Freertos, habilidades para diseño de PCBs y soldadura, como también diseño de la maqueta en SCAD.

Este proyecto nos permitió integrar y aplicar todo lo que hemos aprendido a lo largo de la carrera. Es emocionante ver cómo los conceptos teóricos se vuelven tangibles y funcionales, lo que nos da confianza en nuestras habilidades como futuros ingenieros. Este tipo de proyectos no sólo consolida lo aprendido, sino que también nos acerca a la realidad profesional, demostrando que contamos con las habilidades necesarias para enfrentar desafíos técnicos concretos y desarrollar soluciones creativas y eficaces.

## - Bibliografía

- Configuración de la SD para trabajarla bajo el STM en modo SPI: https://www.st.com/resource/en/application_note/an5595-spc58xexspc58xgx-multimedia-card-via-spi-interface-stmicroelectronics.pdf (https://www.st.com/resource/en/application_note/an5595-spc58xexspc58xgx-multimedia-card-via-spi-interface-stmicroelectronics.pdf) https://elm-chan.org/docs/mmc/mmc_e.htmlhttps://yaseen.ly/writing-data-to-sdcards-without-a-filesystem-spi/
- Configuración de la pantalla TFT ILI9341: https://cdn-shop.adafruit.com/datasheets/ILI9341.pdfhttps://www.lcdwiki.com/res/MSP2402/2.4inch_SPI_Module_MSP2402_User_Manual_EN.pdf (https://www.lcdwiki.com/res/MSP2402/2.4inch_SPI_Module_MSP2402_User_Manual_EN.pdf)
- Configuración del sensor espectral TCS34725:

https://cdn-shop.adafruit.com/datasheets/TCS34725.pdf

## - Panel de firmas

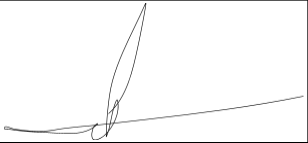
[picture p27: figure]
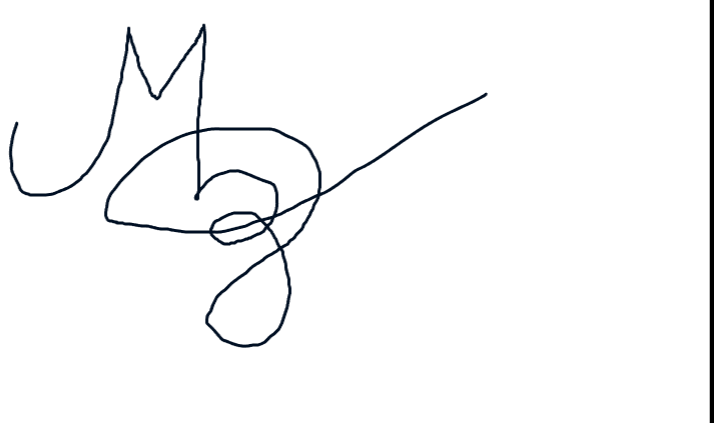
[picture p28: figure]

Integrante I | Integrante II
Fecha: 23/12/2025 | Fecha: 23/12/2025
