mrsilvosa/portfolio/(list of files, drawings)

Other design files:
Light-Spectrometre/Altium-PCB-project/Componentes.PcbLib
Light-Spectrometre/Altium-PCB-project/Espectrometro.PcbDoc
Light-Spectrometre/Altium-PCB-project/Espectrometro_Bank.SchDoc
Light-Spectrometre/Altium-PCB-project/Espectrometro_Micro.SchDoc
Light-Spectrometre/Altium-PCB-project/Espectrometro_Peri.SchDoc
Light-Spectrometre/Altium-PCB-project/Espectrometro_V2.PcbDoc
Light-Spectrometre/Altium-PCB-project/Nucleo.SchLib
Light-Spectrometre/Altium-PCB-project/TD2_Espectrometro.PrjPcb
