mrsilvosa/portfolio/Light-Spectrometre/nucleo-f446re-project/Core/Inc/MY_ILI9341.h

/*
Library:					SPI LCD - ILI9341
Written by:				Mohamed Yaqoob (MYaqoobEmbedded YouTube Channel)
Date Written:			09/12/2018
Last modified:		-/-
Description:			This is an STM32 device driver library for the ILI9341 SPI LCD display, using STM HAL libraries
										
* Copyright (C) 2018 - M. Yaqoob
   This is a free software under the GNU license, you can redistribute it and/or modify it under the terms
   of the GNU General Public Licenseversion 3 as published by the Free Software Foundation.
	
   This software library is shared with puplic for educational purposes, without WARRANTY and Author is not liable for any damages caused directly
   or indirectly by this software, read more about this on the GNU General Public License.
*/

#ifndef _MY_ILI9341_H_
#define _MY_ILI9341_H_

//List of includes
#include <stdbool.h>
//** CHANGE BASED ON STM32 CHIP F4/F7/F1...**//
#include "stm32f4xx_hal.h"   

#include <stdlib.h>
#include <stdio.h>
#include <string.h>

//LCD dimensions defines
#define ILI9341_WIDTH       240
#define ILI9341_HEIGHT      320
#define ILI9341_PIXEL_COUNT	ILI9341_WIDTH * ILI9341_HEIGHT
//ILI9341 LCD commands
#define ILI9341_RESET			 	    	0x01
#define ILI9341_SLEEP_OUT		  			0x11
#define ILI9341_INVERSION_OFF				0x20
#define ILI9341_INVERSION_ON				0x21
#define ILI9341_GAMMA			    		0x26
#define ILI9341_DISPLAY_OFF					0x28
#define ILI9341_DISPLAY_ON					0x29
#define ILI9341_COLUMN_ADDR					0x2A
#define ILI9341_PAGE_ADDR			  		0x2B
#define ILI9341_GRAM				    	0x2C
#define ILI9341_TEARING_OFF					0x34
#define ILI9341_TEARING_ON					0x35
#define ILI9341_DISPLAY_INVERSION			0xb4
#define ILI9341_MAC			        		0x36
#define ILI9341_PIXEL_FORMAT    			0x3A
#define ILI9341_WDB			    	  		0x51
#define ILI9341_WCD				      		0x53
#define ILI9341_RGB_INTERFACE   			0xB0
#define ILI9341_FRC					    	0xB1
#define ILI9341_BPC					    	0xB5
#define ILI9341_DFC				 	    	0xB6
#define ILI9341_Entry_Mode_Set				0xB7
#define ILI9341_POWER1						0xC0
#define ILI9341_POWER2						0xC1
#define ILI9341_VCOM1						0xC5
#define ILI9341_VCOM2						0xC7
#define ILI9341_POWERA						0xCB
#define ILI9341_POWERB						0xCF
#define ILI9341_PGAMMA						0xE0
#define ILI9341_NGAMMA						0xE1
#define ILI9341_DTCA						0xE8
#define ILI9341_DTCB						0xEA
#define ILI9341_POWER_SEQ					0xED
#define ILI9341_3GAMMA_EN					0xF2
#define ILI9341_INTERFACE					0xF6
#define ILI9341_PRC				   	  		0xF7
#define ILI9341_VERTICAL_SCROLL 			0x33

#define ILI9341_MEMCONTROL         			0x36
#define ILI9341_MADCTL_MY  					0x80
#define ILI9341_MADCTL_MX 					0x40
#define ILI9341_MADCTL_MV 					0x20
#define ILI9341_MADCTL_ML  					0x10
#define ILI9341_MADCTL_RGB 					0x00
#define ILI9341_MADCTL_BGR 					0x08
#define ILI9341_MADCTL_MH  					0x04

//List of colors
#define COLOR_BLACK           0x0000  
#define COLOR_NAVY            0x000F      
#define COLOR_DGREEN          0x03E0     
#define COLOR_DCYAN           0x03EF  
#define COLOR_MAROON          0x7800 
#define COLOR_PURPLE          0x780F
#define COLOR_OLIVE           0x7BE0     
#define COLOR_LGRAY           0xC618      
#define COLOR_DGRAY           0x7BEF    
#define COLOR_BLUE            0x001F    
#define COLOR_BLUE2			  0x051D
#define COLOR_GREEN           0x07E0      
#define COLOR_GREEN2		  0xB723
#define COLOR_GREEN3		  0x8000
#define COLOR_CYAN            0x07FF   
#define COLOR_RED             0xF800    
#define COLOR_MAGENTA         0xF81F    
#define COLOR_YELLOW          0xFFE0   
#define COLOR_WHITE           0xFFFF     
#define COLOR_ORANGE          0xFD20     
#define COLOR_GREENYELLOW     0xAFE5     
#define COLOR_BROWN 		  0XBC40
#define COLOR_BRRED 		  0XFC07

//Functions defines Macros
#define swap(a, b) { int16_t t = a; a = b; b = t; }
#define pgm_read_byte(addr) (*(const unsigned char *)(addr))
#define min(a,b) (((a)<(b))?(a):(b))

//***** Functions prototypes *****//
//1. Write Command to LCD
void ILI9341_SendCommand(uint8_t com);
void ILI9341_SendCommand_uint16(uint16_t com);
//2. Write data to LCD
void ILI9341_SendData(uint8_t data);
void ILI9341_SendData_uint16(uint16_t data);
//2.2 Write multiple/DMA
void ILI9341_SendData_Multi(uint16_t Colordata, uint32_t size);
void ILI9341_SendData_Multi_uint16(uint16_t Colordata, uint32_t size);


//3. Set cursor position
void ILI9341_SetCursorPosition(uint16_t x1, uint16_t y1, uint16_t x2, uint16_t y2);
void ILI9341_SetCursorPosition_uint16(uint16_t x1, uint16_t y1, uint16_t x2, uint16_t y2);
//4. Initialise function
void ILI9341_Init(SPI_HandleTypeDef *spiLcdHandle, GPIO_TypeDef *csPORT, uint16_t csPIN, GPIO_TypeDef *dcPORT, uint16_t dcPIN, GPIO_TypeDef *resetPORT, uint16_t resetPIN);
//5. Write data to a single pixel
void ILI9341_DrawPixel(uint16_t x, uint16_t y, uint16_t color); //Draw single pixel to ILI9341
void ILI9341_DrawPixel_uint16(uint16_t x, uint16_t y, uint16_t color);
//6. Fill the entire screen with a background color
void ILI9341_Fill(uint16_t color); //Fill entire ILI9341 with color
void ILI9341_Fill_DMA(uint16_t color, uint16_t w, uint16_t h, uint8_t* bufferColored);
void ILI9341_Fill_uint16(uint16_t color);
//7. Rectangle drawing functions
void ILI9341_Fill_Rect(unsigned int x0, unsigned int y0, unsigned int x1, unsigned int y1, uint16_t color);
void ILI9341_Fill_Rect_uint16(unsigned int x0,unsigned int y0, unsigned int x1,unsigned int y1, uint16_t color);
//8. Circle drawing functions
void ILI9341_drawCircle(int16_t x0, int16_t y0, int16_t r, uint16_t color);
void drawCircleHelper( int16_t x0, int16_t y0, int16_t r, uint8_t cornername, uint16_t color);
void fillCircleHelper(int16_t x0, int16_t y0, int16_t r, uint8_t cornername, int16_t delta, uint16_t color);
void ILI9341_fillCircle(int16_t x0, int16_t y0, int16_t r, uint16_t color);
//9. Line drawing functions
void ILI9341_drawLine(int16_t x0, int16_t y0, int16_t x1, int16_t y1, uint16_t color);
void ILI9341_drawFastHLine(int16_t x, int16_t y, int16_t w, uint16_t color);
void ILI9341_drawFastVLine(int16_t x, int16_t y, int16_t h, uint16_t color);
//10. Triangle drawing
void ILI9341_drawTriangle(int16_t x0, int16_t y0, int16_t x1, int16_t y1, int16_t x2, int16_t y2, uint16_t color);
void ILI9341_fillTriangle(int16_t x0, int16_t y0, int16_t x1, int16_t y1, int16_t x2, int16_t y2, uint16_t color);
//11. Text printing functions
void ILI9341_drawChar(int16_t x, int16_t y, unsigned char c, uint16_t color, uint16_t bg, uint8_t size);
void ILI9341_drawChar_uint16(int16_t x, int16_t y, unsigned char c, uint16_t color, uint16_t bg, uint8_t size);
void ILI9341_printText(char text[], int16_t x, int16_t y, uint16_t color, uint16_t bg, uint8_t size);
void ILI9341_printText_uint16(char text[], int16_t x, int16_t y, uint16_t color, uint16_t bg, uint8_t size);
//12. Image print (RGB 565, 2 bytes per pixel)
void ILI9341_printImage(uint16_t x, uint16_t y, uint16_t w, uint16_t h, uint16_t *data, uint32_t size);
void ILI9341_printImage_uint16(uint16_t x, uint16_t y, uint16_t w, uint16_t h, uint16_t *data);
//13. Set screen rotation
void ILI9341_setRotation(uint8_t rotate);
void ILI9341_setRotation_uint16(uint8_t rotate);
//14. Get screen rotation
uint8_t ILI9341_getRotation(void);

void ILI9341_inversion_on(void);
void ILI9341_inversion_off(void);

void ILI9341_adjust_display_brightness(uint8_t brightness);
void ILI9341_control_display(uint8_t brightness_on, uint8_t displayDimming_on, uint8_t backlightControl_on);

void ILI9341_printImageSector_512bytes(uint16_t x, uint16_t y, uint16_t w, uint16_t h, uint8_t* bufferRx, bool isFirstBlock);
void ILI9341_printImageSector_512bytes_DMA_start_finish(uint16_t x, uint16_t y, uint16_t w, uint16_t h, uint8_t* bufferRx, bool isFirstBlock);
void ILI9341_printImageSector_512bytes_DMA_start(uint16_t x, uint16_t y, uint16_t w, uint16_t h, uint8_t* bufferRx, bool isFirstBlock);
void ILI9341_printImageSector_512bytes_DMA_finish(void);

// declaración adelantada de la estructura BSP
// la lógica sabe que existe pero no sabe cómo es
typedef struct ILI9341_BSP_variables ILI9341_BSP_variables_t;

typedef struct
{
	// Contenido del hw lo tendrá incorporado el BSP
	// a menos que existan varios ILI9341 en el mismo proyecto, es mejor así.

	//ILI9341_BSP_variables_t* HW_variables; -> al BSP

	// init: no tiene sentido que exista porque necesito linkearlo
	// ILI9341.init(&hw_vars) -> el ILI9341 ya tendría que tener init linkeado
	// pero cuándo se haría? no tiene sentido

	//void (*init)(ILI9341_BSP_variables_t* toSelf); -> no puede existir

	/*
	 * Funciones lógicas que usará el usuario:
	 */

	//6. Fill the entire screen with a background color
	void (*fill)(uint16_t color);
	void (*fill_DMA)(uint16_t color, uint16_t w, uint16_t h, uint8_t* bufferColored);
	//7. Rectangle drawing functions
	void (*fillRectangle)(unsigned int x0,unsigned int y0, unsigned int x1,unsigned int y1, uint16_t color);
	//5. Write data to a single pixel
	void (*drawPixel)(uint16_t x, uint16_t y, uint16_t color);
	//8. Circle drawing functions
	void (*drawCircumference)(int16_t x0, int16_t y0, int16_t r, uint16_t color);
	//9. Line drawing functions
	void (*drawLine)(int16_t x0, int16_t y0, int16_t x1, int16_t y1, uint16_t color);
	// fill a circle function:
	void (*fillCircle)(int16_t x0, int16_t y0, int16_t r, uint16_t color);
	// draw fast lines functions:
	void (*drawFastHLine)(int16_t x, int16_t y, int16_t w, uint16_t color);
	void (*drawFastVLine)(int16_t x, int16_t y, int16_t h, uint16_t color);
	//10. Triangle drawing
	void (*drawTriangleOutline)(int16_t x0, int16_t y0, int16_t x1, int16_t y1, int16_t x2, int16_t y2, uint16_t color);
	// fill a triangle:
	void (*fillTriangle)(int16_t x0, int16_t y0, int16_t x1, int16_t y1, int16_t x2, int16_t y2, uint16_t color);
	//11. Text printing functions
	void (*drawChar)(int16_t x, int16_t y, unsigned char c, uint16_t color, uint16_t bg, uint8_t size);
	void (*printText)(char text[], int16_t x, int16_t y, uint16_t color, uint16_t bg, uint8_t size);
	//12. Image print (RGB 565, 2 bytes per pixel)
	void (*printImage)(uint16_t x, uint16_t y, uint16_t w, uint16_t h, uint16_t *data, uint32_t size);
	//13. Set screen rotation
	void (*setRotation)(uint8_t rotate);
	//14. Get screen rotation
	uint8_t (*getRotation)(void);
	void (*inversionON)(void);
	void (*inversionOFF)(void);
	void (*adjustDisplayBrightness)(uint8_t brightness);
	void (*controlDisplay)(uint8_t brightness_on, uint8_t displayDimming_on, uint8_t backlightControl_on);
	void (*printImageSector_512bytes)(uint16_t x, uint16_t y, uint16_t w, uint16_t h, uint8_t* bufferRx, bool isFirstBlock);
	//15. print a block out of 300 of an image via DMA no ISR
	void (*printImageSector_512bytes_DMA_start_finish)(uint16_t x, uint16_t y, uint16_t w, uint16_t h, uint8_t* bufferRx, bool isFirstBlock);
	//16. print a block out of 300 of an image via DMA with ISR on mind. Must call ..._DMA_finish() when it finishes.
	void (*printImageSector_512bytes_DMA_start)(uint16_t x, uint16_t y, uint16_t w, uint16_t h, uint8_t* bufferRx, bool isFirstBlock);
	void (*printImageSector_512bytes_DMA_finish)(void);
}ILI9341_t;

// prototipo de la funcion de inicializacion implementada en ILI9341.c:
// esta función construye al ILI9341_t :
void ILI9341_Class_Init(ILI9341_t* self,ILI9341_BSP_variables_t* variables);

#endif /* MY_ILI9341.h */
