mrsilvosa/portfolio/(notices)

Notices in the files:
Light-Spectrometre/nucleo-f446re-project/Core/Inc/main.h:
Copyright (c) 2025 STMicroelectronics.
All rights reserved.
This software is licensed under terms that can be found in the LICENSE file
